ksu-eclub/magnetic-chess/mechanical/Pieces/king.PNG

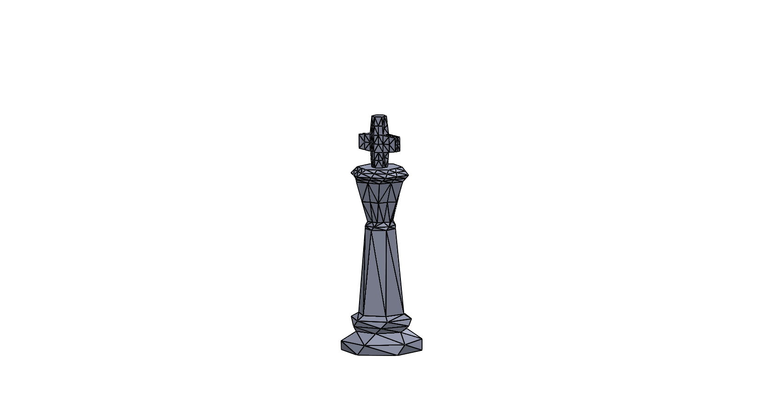
mechanical/Pieces/king.PNG
