ksu-eclub/magnetic-chess/mechanical/Board/LED Module Jig.SLDASM

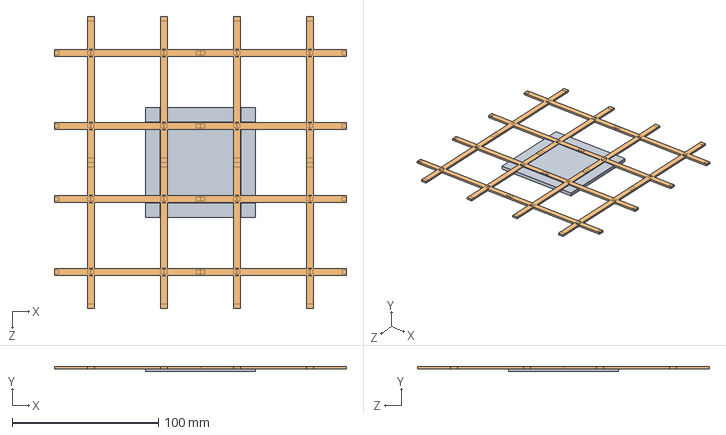
[picture p2: CAD file, 2020-03-06]
mechanical/Board/LED Module Jig.SLDASM
200.0 x 3.67 x 200.0 mm
LED Module Jig
LED Module x 4
