ksu-eclub/magnetic-chess/mechanical/Drag Chain/Drag Chain.SLDASM

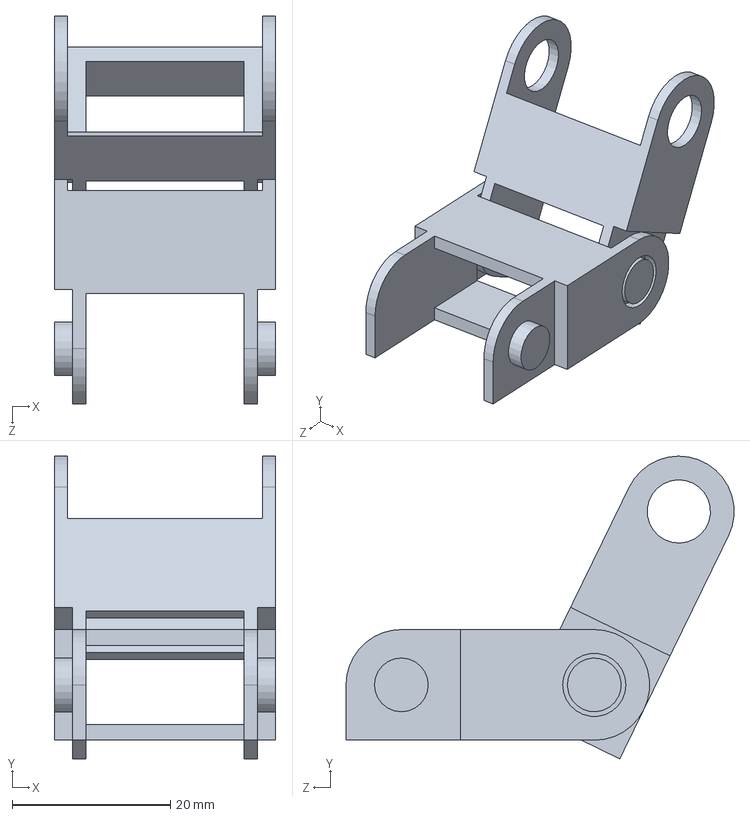
[picture p3: CAD file, 2020-02-17]
mechanical/Drag Chain/Drag Chain.SLDASM
28.0 x 38.3 x 49.1 mm
Drag Chain Link x 2
