ksu-eclub/magnetic-chess/mechanical/Magnetic Chess.SLDASM

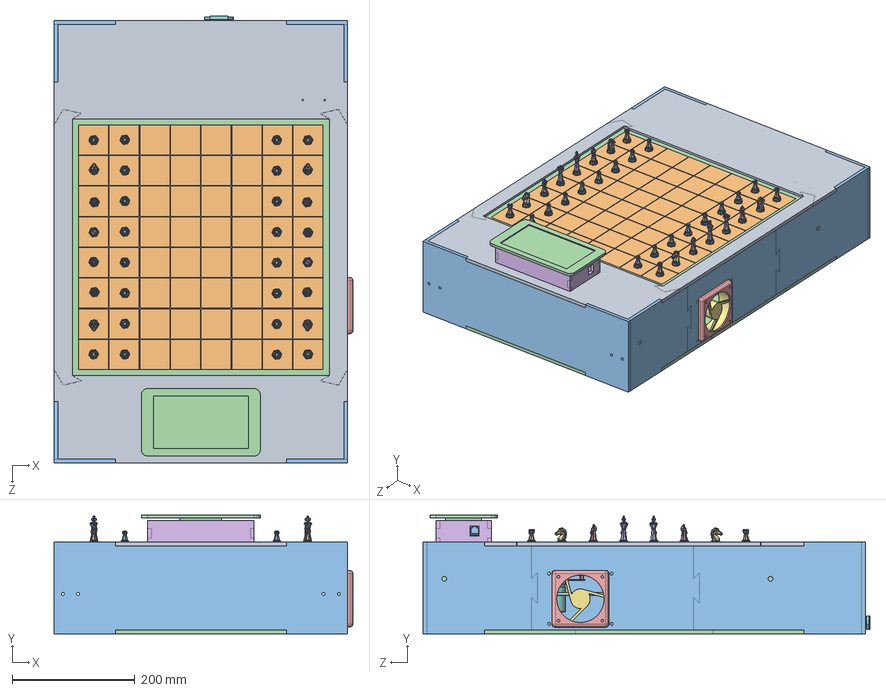
[picture p4: CAD file, 2020-02-26]
mechanical/Magnetic Chess.SLDASM
487.6 x 193.9 x 728.2 mm
Top
Top Board Mount x 4
Side x 4
Bottom
Fan Mount
Screen Side x 4
PSU Side x 2
PSU Top
Trim x 49
Tile x 64
LED Module x 16
Clear Board Epoxy
Bishop x 4
king x 2
knight x 4
pawn x 16
queen x 2
rook x 4
Power Supply
Axle x 10
Bearing x 16
Bearing Flange x 4
Pulley x 12
Belt x 6
Stepper Motor x 2
Stepper Plate
Cross-Axis Support x 2
Clamp x 4
Standoff x 31
stepper x 2
Magnet Holder
magnet driver
Electromagnet
Pi Hat
Raspberry Pi 3
Touch Screen
LED Controller
Power Entry
Fan
Power Plug
