ksu-eclub/magnetic-chess/mechanical/Board/Board.SLDASM

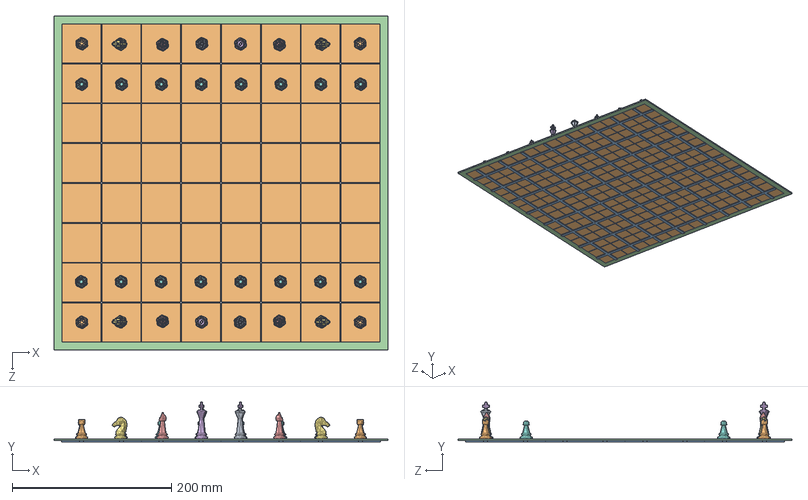
[picture p5: CAD file, 2020-02-17]
mechanical/Board/Board.SLDASM
419.0 x 50.1 x 419.0 mm
Trim x 49
Tile x 64
LED Module x 16
Clear Board Epoxy
Bishop x 4
king x 2
knight x 4
pawn x 16
queen x 2
rook x 4
