ksu-eclub/magnetic-chess/mechanical/Gantry/Secondary Axis.SLDASM

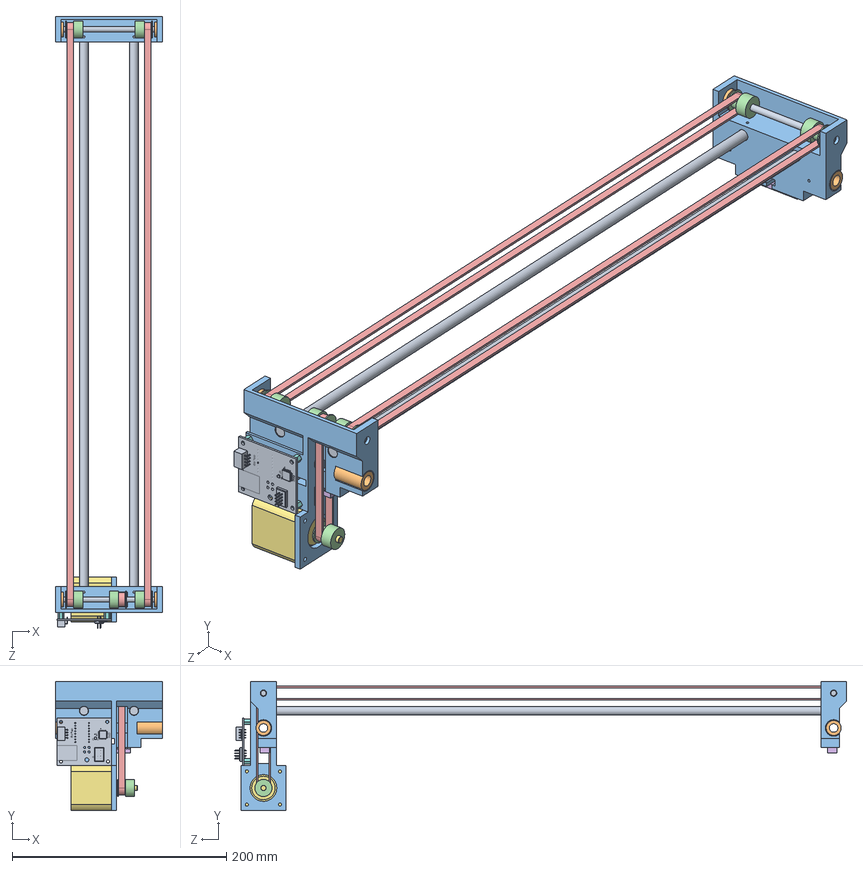
[picture p6: CAD file, 2020-02-26]
mechanical/Gantry/Secondary Axis.SLDASM
100.0 x 120.7 x 571.0 mm
Axle x 4
Bearing x 8
Cross-Axis Support x 2
Pulley x 6
Belt x 3
Clamp x 2
Stepper Motor
Standoff x 4
stepper
