ksu-eclub/magnetic-chess/mechanical/Box/Box.SLDASM

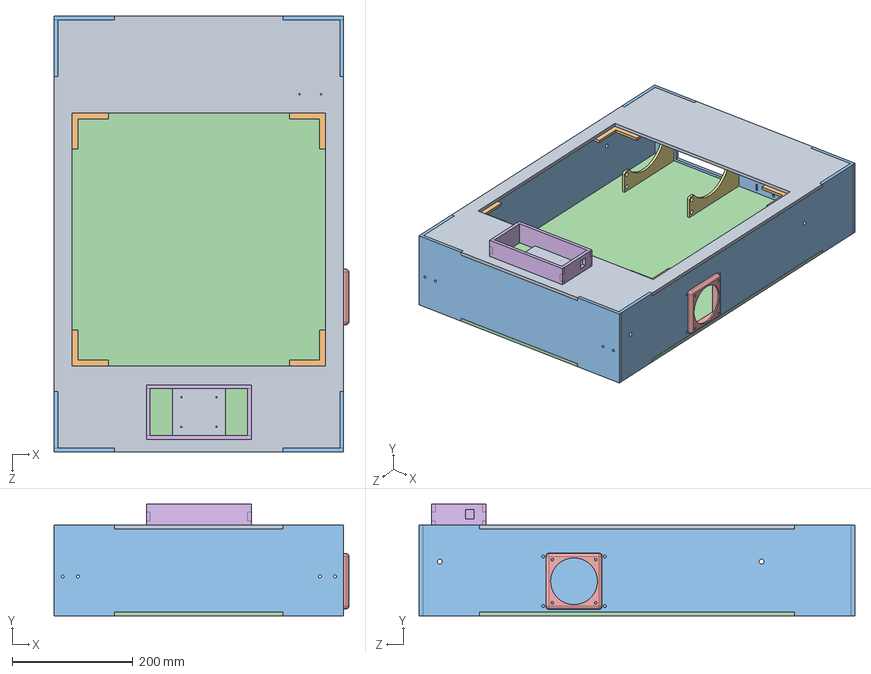
[picture p7: CAD file, 2020-02-20]
mechanical/Box/Box.SLDASM
487.6 x 185.0 x 721.0 mm
Top
Top Board Mount x 4
Side x 4
Bottom
Fan Mount
Screen Side x 4
PSU Side x 2
PSU Top
