ksu-eclub/magnetic-chess/mechanical/Gantry/Magnet Holder.SLDASM

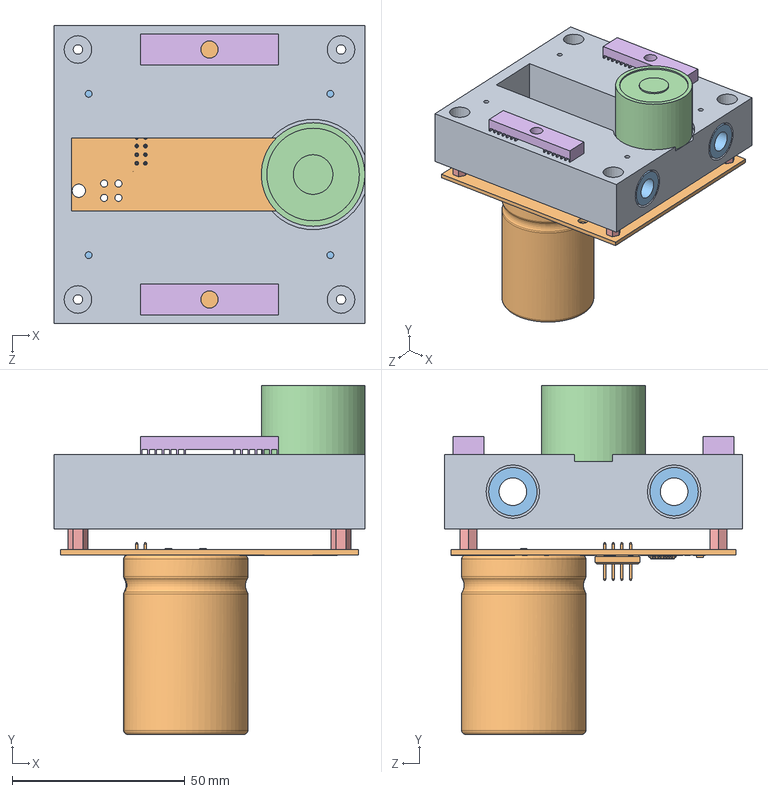
[picture p8: CAD file, 2020-02-26]
mechanical/Gantry/Magnet Holder.SLDASM
90.0 x 101.1 x 86.2 mm
Magnet Holder
magnet driver
Bearing x 4
Electromagnet
Standoff x 4
Clamp x 2
