ksu-eclub/magnetic-chess/mechanical/Laser-Cutting/0.25in MDF - Magnetic Chess.SLDASM

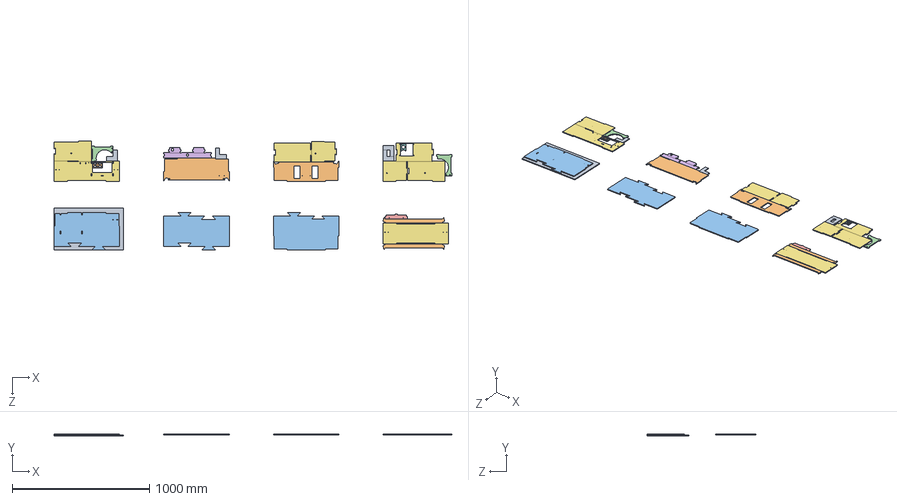
[picture p9: CAD file, 2020-02-21]
mechanical/Laser-Cutting/0.25in MDF - Magnetic Chess.SLDASM
2903.4 x 12.7 x 793.7 mm
Bearing Flange x 4
Bottom x 3
PSU Side x 2
PSU Top
Screen Side x 4
Side x 8
Stepper Plate
Top Board Mount x 4
Top x 4
