ksu-eclub/magnetic-chess/mechanical/Box/Lid.SLDASM

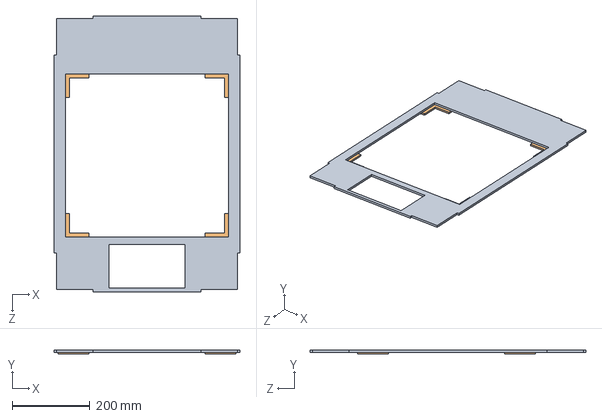
[picture p10: CAD file, 2020-02-20]
mechanical/Box/Lid.SLDASM
479.0 x 11.4 x 711.0 mm
Top
Top Board Mount x 4
