ksu-eclub/magnetic-chess/mechanical/Gantry/Base Pulley Rod.SLDASM

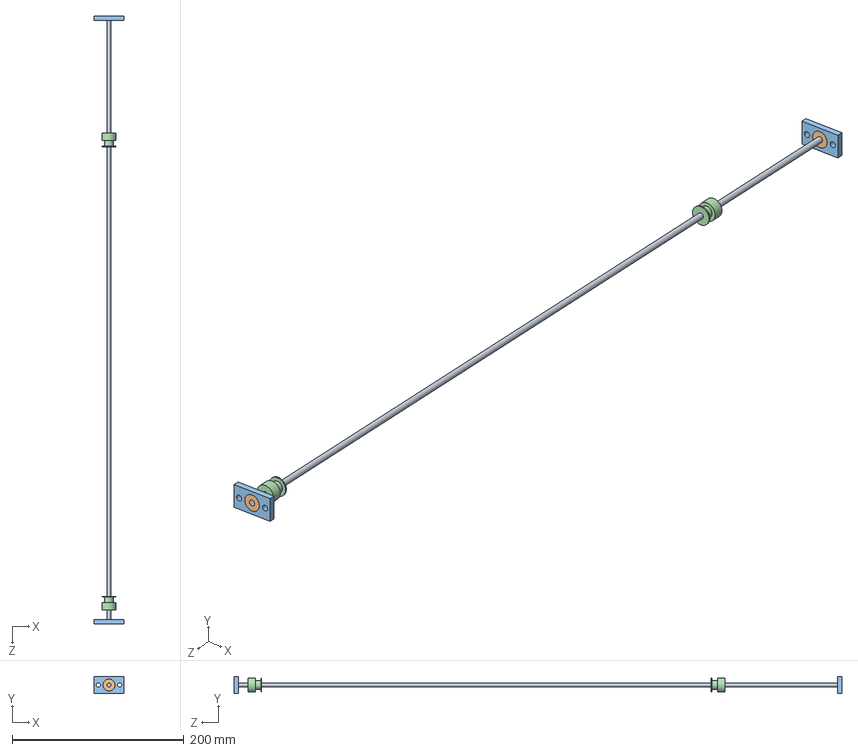
[picture p11: CAD file, 2020-02-20]
mechanical/Gantry/Base Pulley Rod.SLDASM
35.0 x 20.0 x 708.3 mm
Axle
Bearing x 2
Bearing Flange x 2
Pulley x 2
