ksu-eclub/magnetic-chess/mechanical/Gantry/Gantry Testing.SLDASM

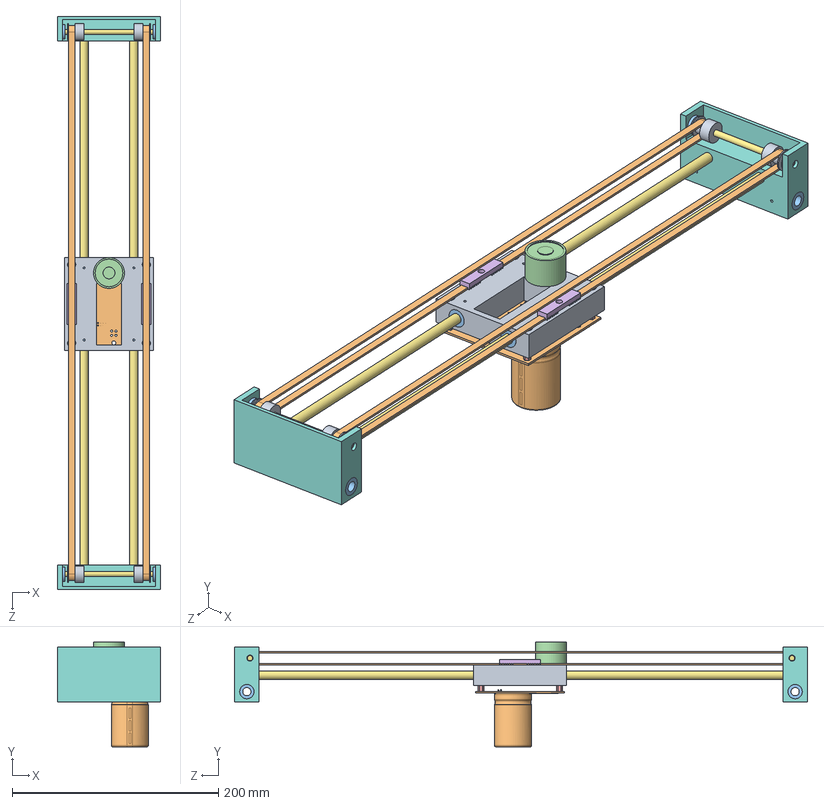
[picture p12: CAD file, 2020-02-19]
mechanical/Gantry/Gantry Testing.SLDASM
100.0 x 101.6 x 556.0 mm
Magnet Holder
magnet driver
Bearing x 12
Electromagnet
Standoff x 4
Clamp x 2
Axle x 4
Cross-Axis Support x 2
Pulley x 4
Belt x 2
