ksu-eclub/magnetic-chess/mechanical/Gantry/Gantry.SLDASM

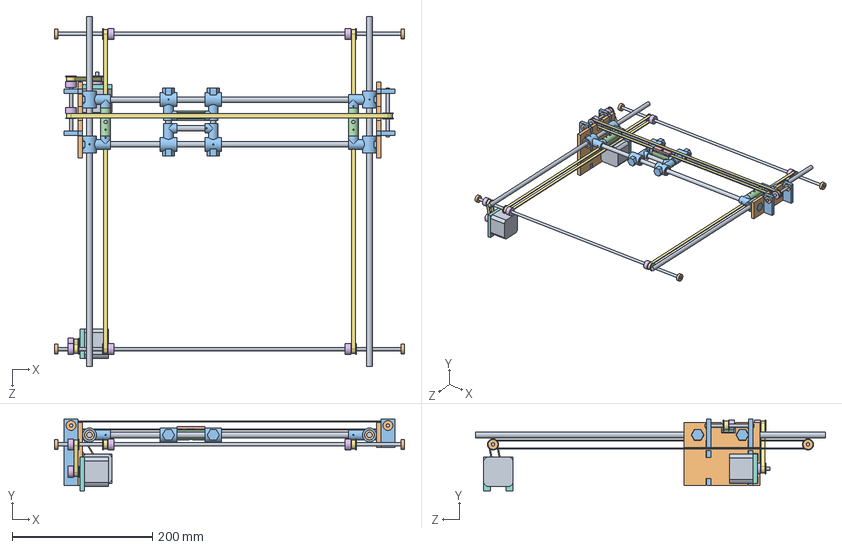
[picture p13: CAD file, 2020-02-19]
mechanical/Gantry/Gantry.SLDASM
500.0 x 102.8 x 500.0 mm
Axle x 14
Bearing x 16
Linear Bearing Holder x 8
Clamp Plate x 3
Clamp x 3
Pulley x 10
Belt x 5
Stepper Plate x 2
Stepper Motor x 2
Y Attachment Plate x 2
Y Rib x 4
