ksu-eclub/magnetic-chess/mechanical/3D Printing/LED Module Jig.STL

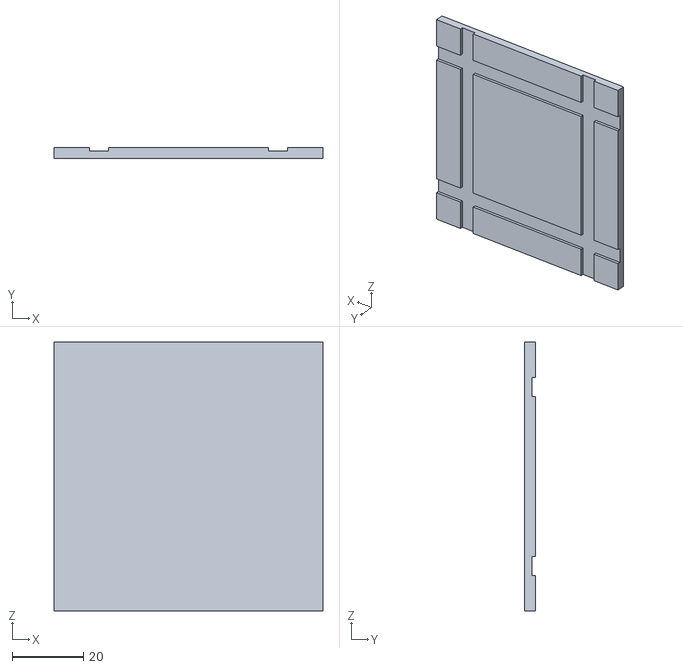
[picture p14: CAD file, 2020-03-06]
mechanical/3D Printing/LED Module Jig.STL
75.6 x 3.00 x 75.6
