ksu-eclub/magnetic-chess/mechanical/Box/Side.SLDPRT

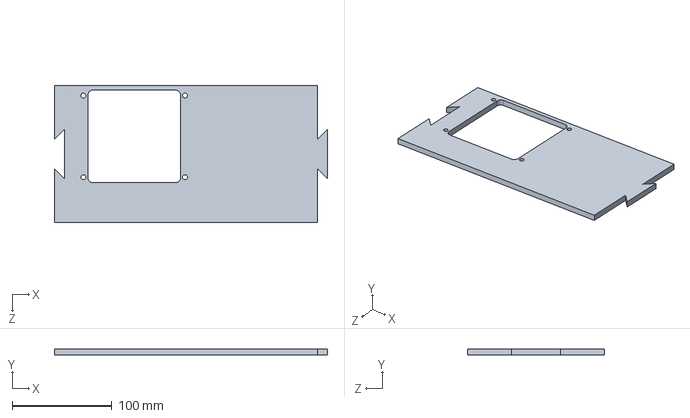
[picture p15: CAD file, 2020-02-20]
mechanical/Box/Side.SLDPRT
274.0 x 6.35 x 137.3 mm
