ksu-eclub/magnetic-chess/mechanical/Commercial Parts/Standoff.SLDPRT

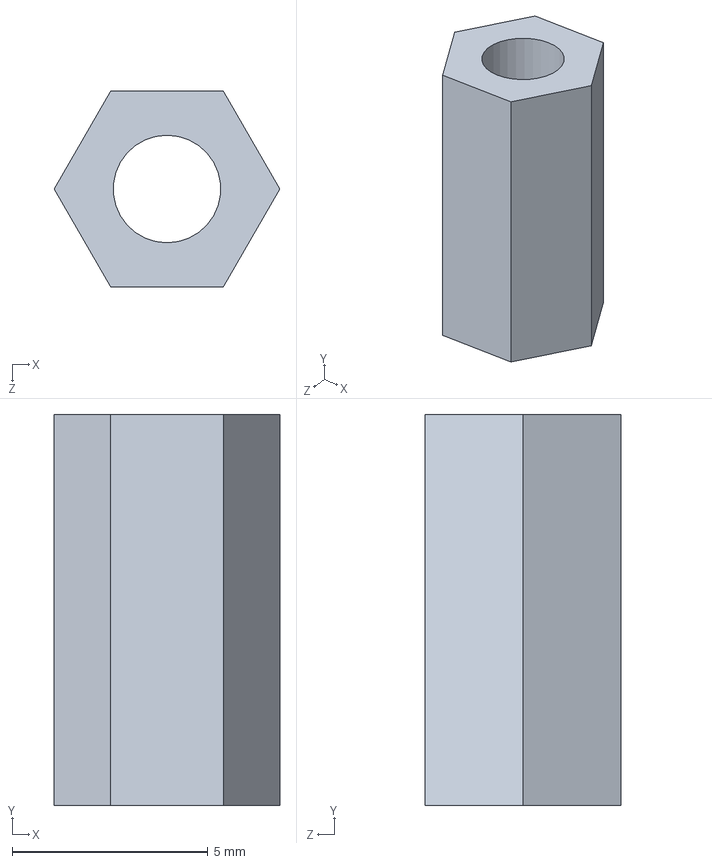
[picture p16: CAD file, 2020-02-19]
mechanical/Commercial Parts/Standoff.SLDPRT
5.77 x 10.0 x 5.00 mm
