ksu-eclub/magnetic-chess/mechanical/Gantry/Pulley Spacer.SLDPRT

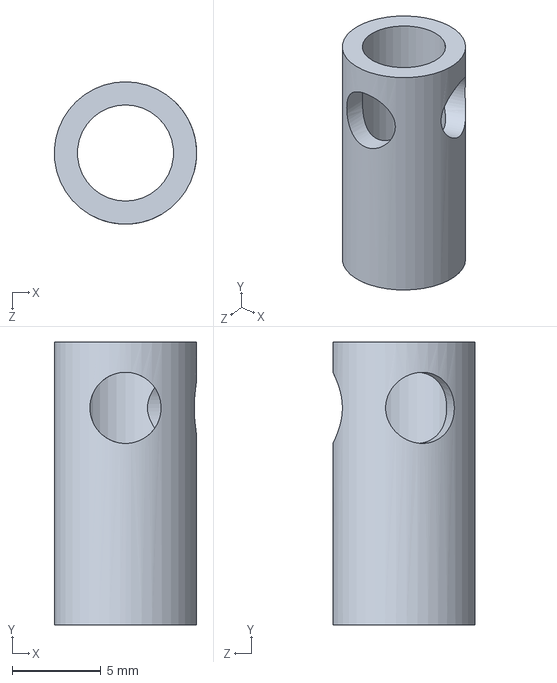
[picture p17: CAD file, 2020-02-28]
mechanical/Gantry/Pulley Spacer.SLDPRT
8.00 x 15.9 x 8.00 mm
