ksu-eclub/magnetic-chess/mechanical/PCBs/LED Controller.step

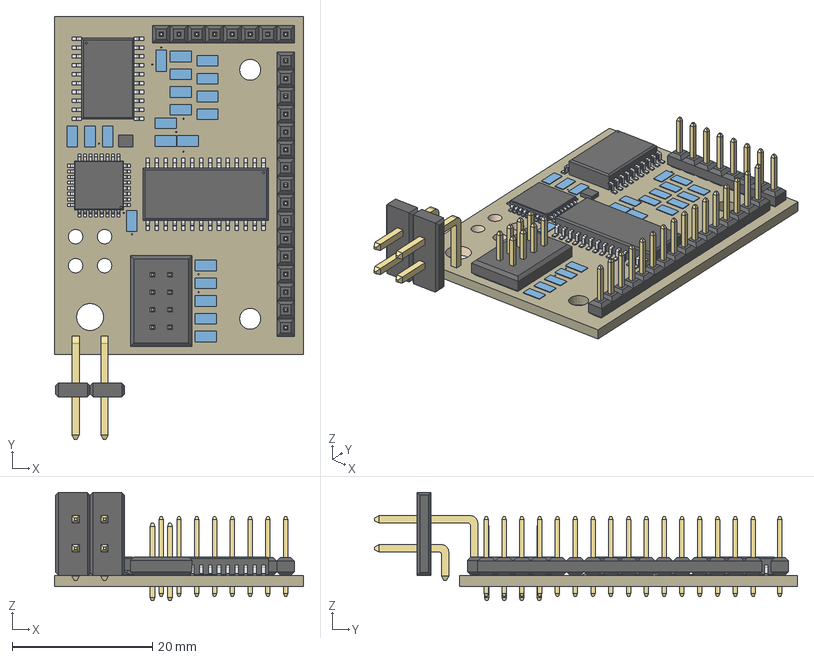
[picture p19: CAD file, 2020-02-17]
mechanical/PCBs/LED Controller.step
35.6 x 60.4 x 15.5 mm
Board
10k x 21
DF1BZ-8DP-2.5DSA
LED8
LED16
MCP23S08-E/SO
ATMEGA328PB32-TQFP
MCP23S17T-E/SO
8 MHz
