ksu-eclub/magnetic-chess/mechanical/Pieces/Bishop.SLDPRT

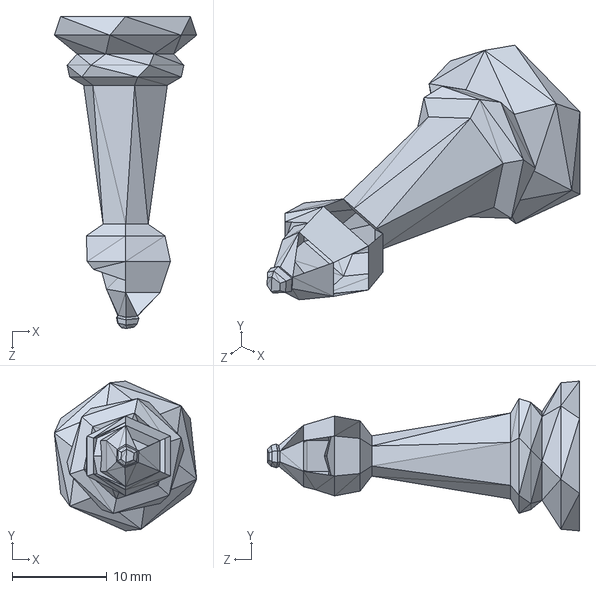
[picture p20: CAD file, 2020-02-17]
mechanical/Pieces/Bishop.SLDPRT
15.1 x 15.8 x 33.0 mm
