ksu-eclub/magnetic-chess/mechanical/Box/Top.SLDPRT

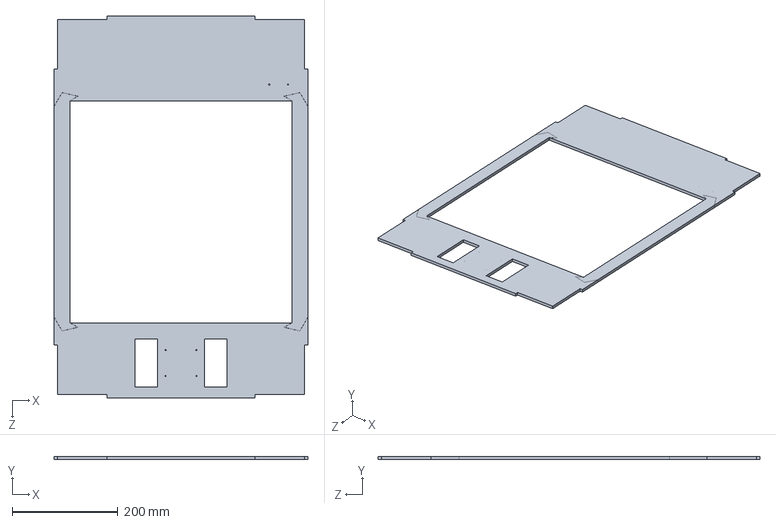
[picture p21: CAD file, 2020-02-20]
mechanical/Box/Top.SLDPRT
479.0 x 6.35 x 721.0 mm
