ksu-eclub/magnetic-chess/mechanical/Commercial Parts/Raspberry Pi 3.SLDPRT

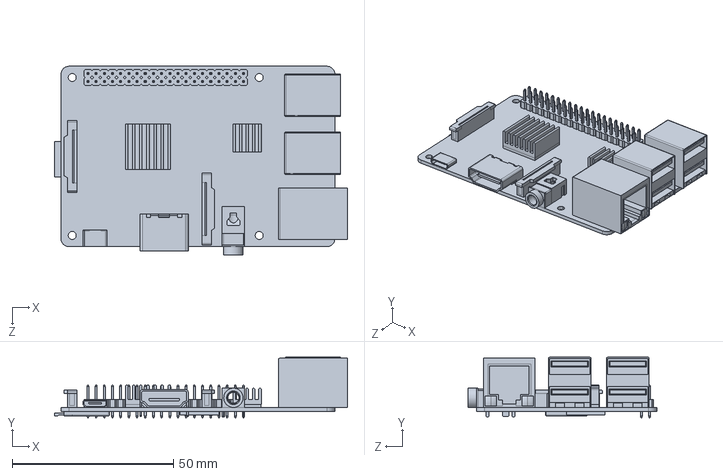
[picture p22: CAD file, 2020-02-19]
mechanical/Commercial Parts/Raspberry Pi 3.SLDPRT
90.9 x 18.8 x 58.5 mm
