ksu-eclub/magnetic-chess/mechanical/Drag Chain/Drag Chain Link.SLDPRT

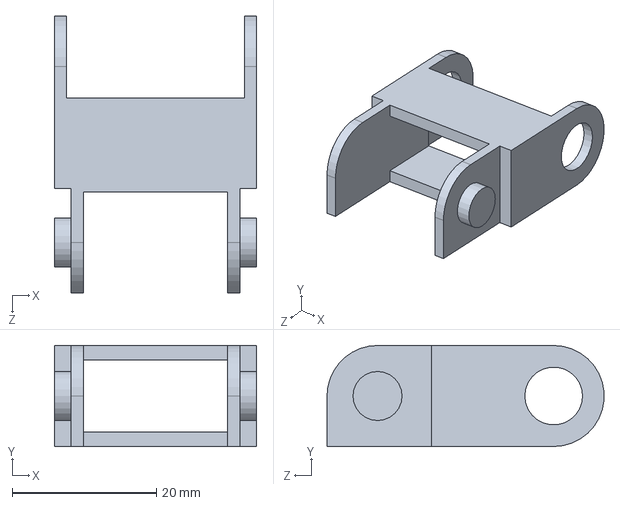
[picture p23: CAD file, 2020-02-17]
mechanical/Drag Chain/Drag Chain Link.SLDPRT
28.0 x 14.0 x 38.4 mm
