ksu-eclub/magnetic-chess/mechanical/Laser-Cutting/0.25in MDF - Magnetic Chess - 8.dxf

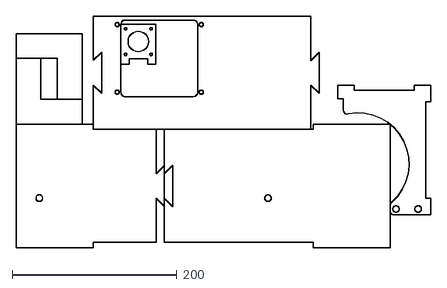
[picture p24: CAD file, 2020-02-21]
mechanical/Laser-Cutting/0.25in MDF - Magnetic Chess - 8.dxf
503.4 x 281.0
