ksu-eclub/magnetic-chess/mechanical/PCBs/Power Entry.step

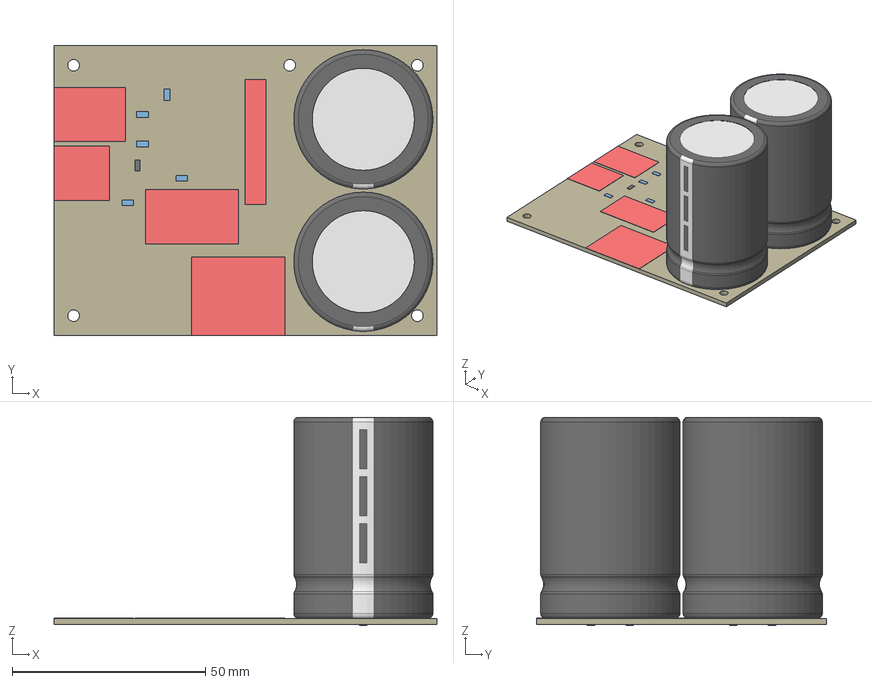
[picture p25: CAD file, 2020-02-17]
mechanical/PCBs/Power Entry.step
99.1 x 74.9 x 53.9 mm
Board
GBJ1004-BP
1000 uF x 2
2.7M x 5
BAT54HT1GBAT54HT1G
ALQ3F12
703W-00/04
