ksu-eclub/magnetic-chess/mechanical/Pieces/queen.SLDPRT

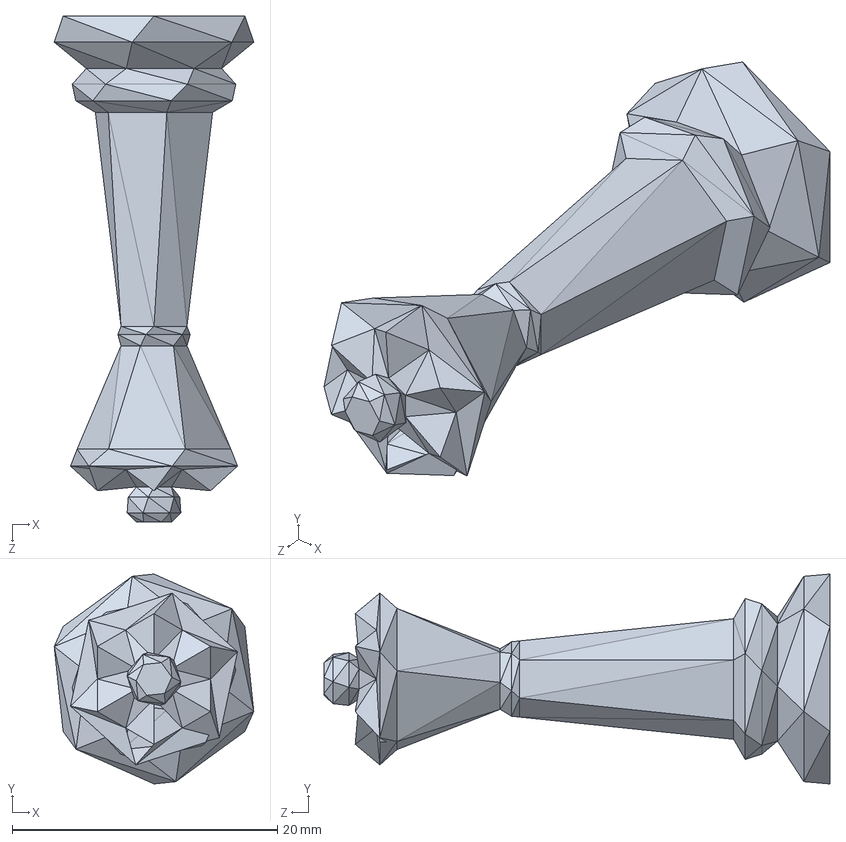
[picture p26: CAD file, 2020-02-17]
mechanical/Pieces/queen.SLDPRT
15.1 x 15.8 x 38.2 mm
