ksu-eclub/magnetic-chess/mechanical/3D Printing/Cross-Axis Support - Idler.STL

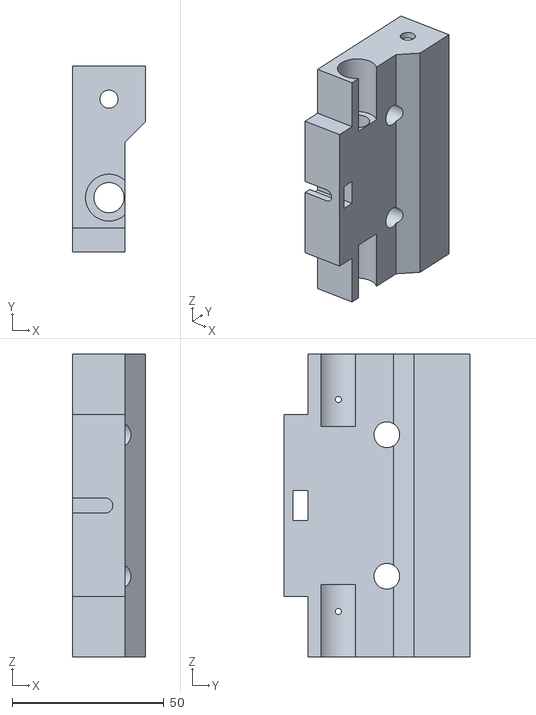
[picture p27: CAD file, 2020-02-26]
mechanical/3D Printing/Cross-Axis Support - Idler.STL
24.0 x 61.5 x 100.0
