ksu-eclub/magnetic-chess/mechanical/Board/Clear Board Epoxy.SLDPRT

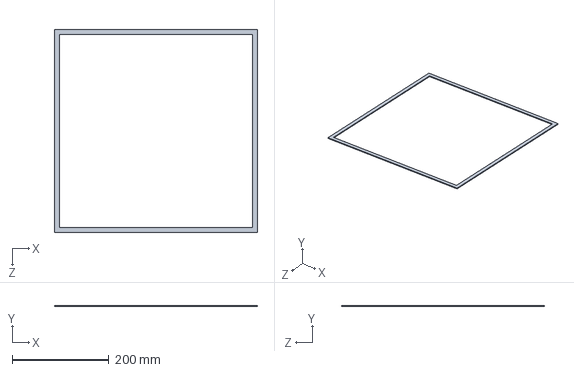
[picture p28: CAD file, 2020-02-17]
mechanical/Board/Clear Board Epoxy.SLDPRT
419.0 x 2.20 x 419.0 mm
