ksu-eclub/magnetic-chess/mechanical/Commercial Parts/Power Plug.SLDPRT

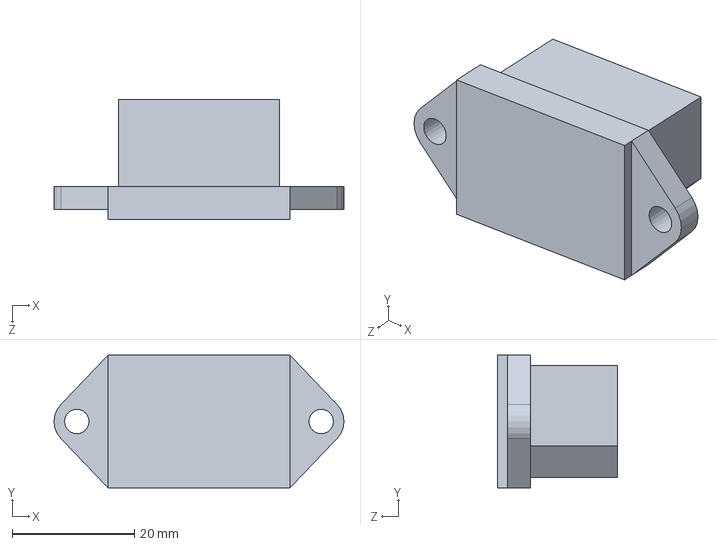
[picture p29: CAD file, 2020-02-17]
mechanical/Commercial Parts/Power Plug.SLDPRT
47.5 x 21.7 x 19.6 mm
