ksu-eclub/magnetic-chess/mechanical/PCBs/Pi Hat.step

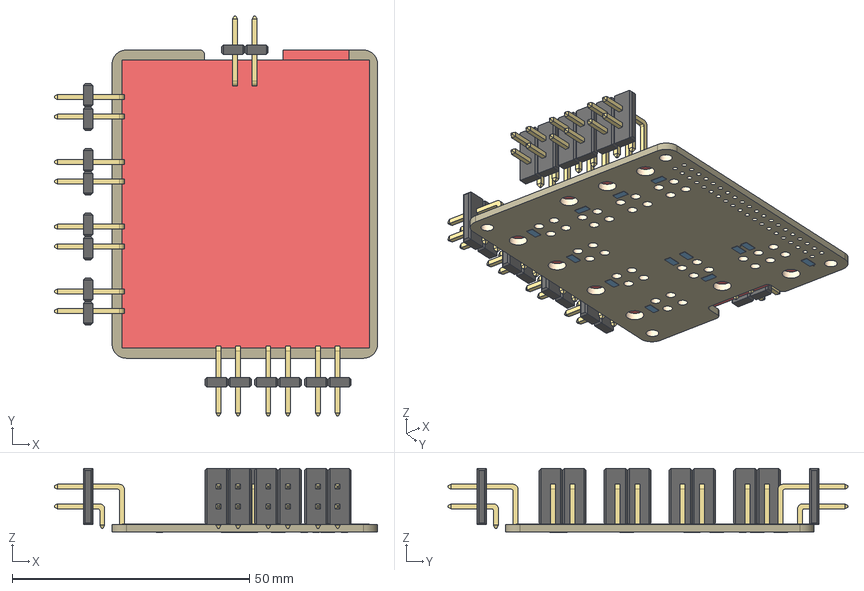
[picture p30: CAD file, 2020-02-17]
mechanical/PCBs/Pi Hat.step
68.2 x 84.3 x 13.5 mm
Board
4.7k x 13
RPI
