ksu-eclub/magnetic-chess/mechanical/Pieces/knight.SLDPRT

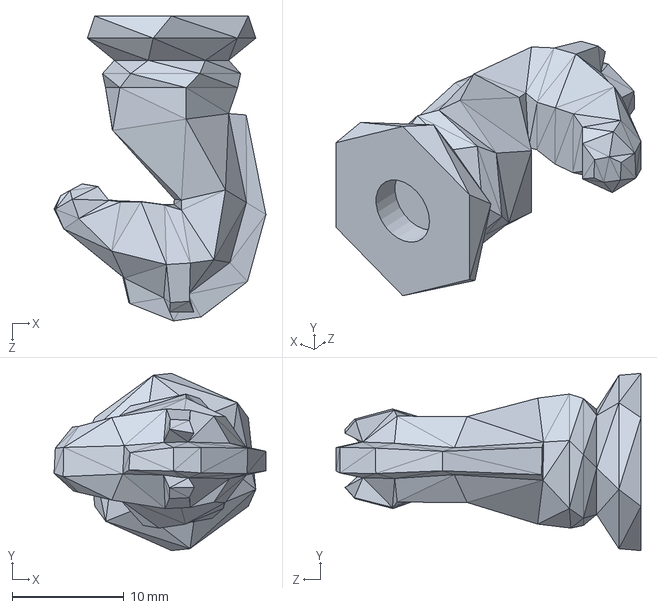
[picture p31: CAD file, 2020-02-17]
mechanical/Pieces/knight.SLDPRT
18.9 x 15.8 x 27.3 mm
