ksu-eclub/magnetic-chess/mechanical/3D Printing/Cross-Axis Support - Driver.STL

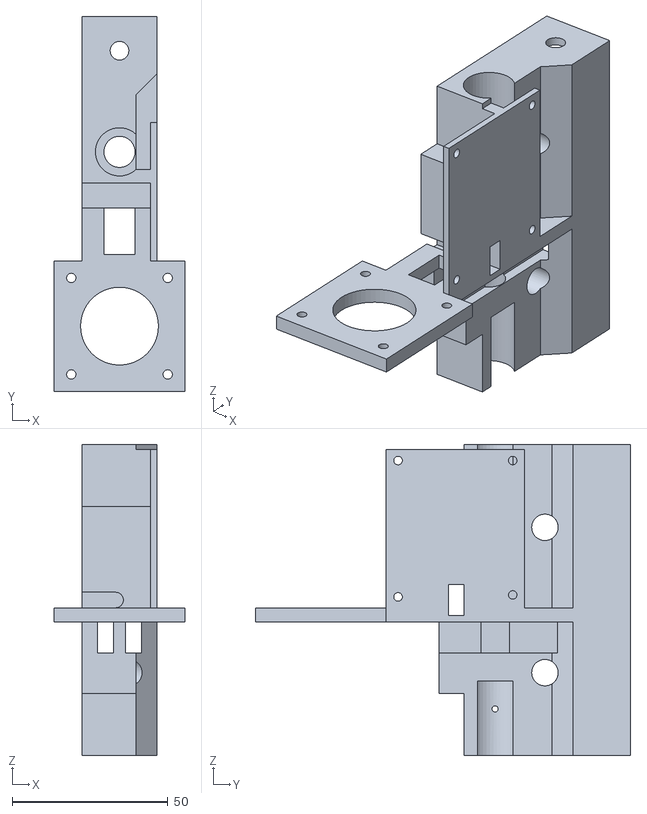
[picture p32: CAD file, 2020-02-26]
mechanical/3D Printing/Cross-Axis Support - Driver.STL
42.0 x 120.5 x 100.0
