ksu-eclub/magnetic-chess/mechanical/Board/Tile.SLDPRT

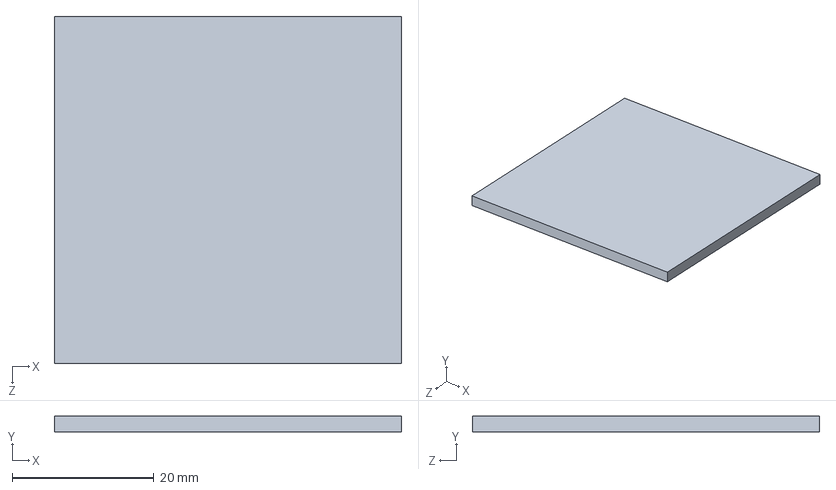
[picture p33: CAD file, 2020-02-17]
mechanical/Board/Tile.SLDPRT
49.0 x 2.20 x 49.0 mm
