ksu-eclub/magnetic-chess/mechanical/Box/Bottom.SLDPRT

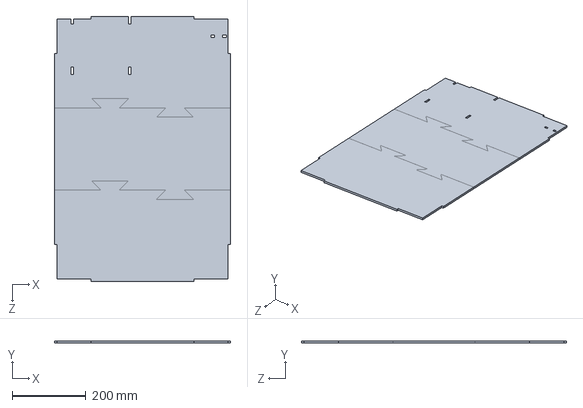
[picture p34: CAD file, 2020-02-20]
mechanical/Box/Bottom.SLDPRT
479.0 x 6.35 x 721.0 mm
