ksu-eclub/magnetic-chess/mechanical/Commercial Parts/Fan.SLDPRT

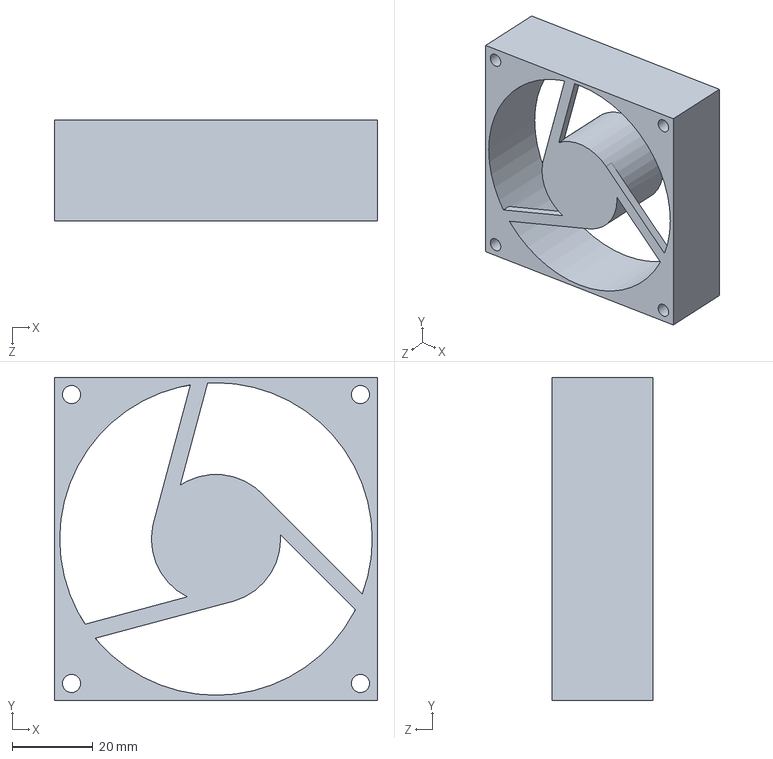
[picture p35: CAD file, 2020-02-17]
mechanical/Commercial Parts/Fan.SLDPRT
80.0 x 80.0 x 25.1 mm
