ksu-eclub/magnetic-chess/mechanical/Laser-Cutting/0.25in MDF - Magnetic Chess - 3.dxf

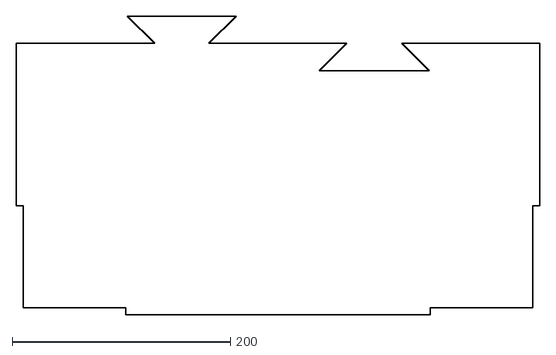
[picture p36: CAD file, 2020-02-21]
mechanical/Laser-Cutting/0.25in MDF - Magnetic Chess - 3.dxf
479.0 x 273.6
