ksu-eclub/magnetic-chess/mechanical/PCBs/stepper.step

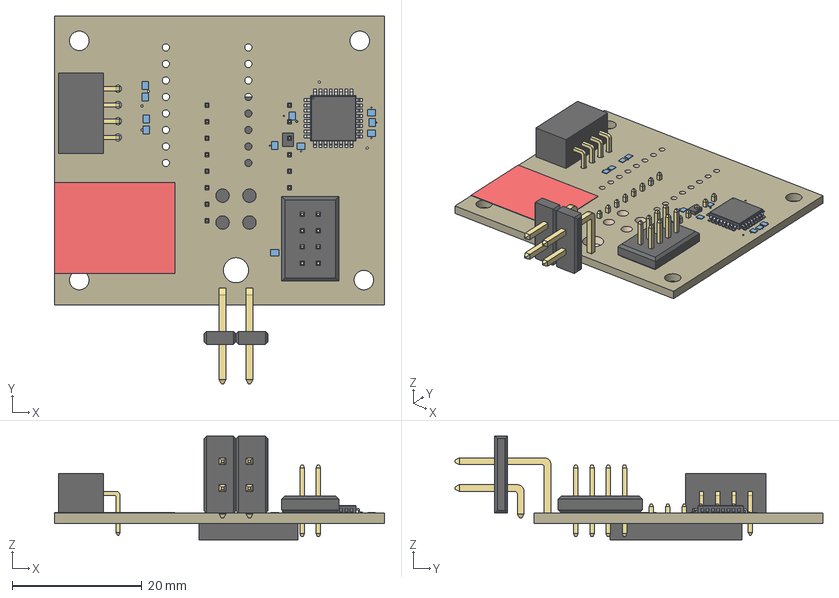
[picture p37: CAD file, 2020-02-17]
mechanical/PCBs/stepper.step
50.8 x 56.6 x 16.0 mm
Board
STEPPER_DRIVER
10k x 11
DF1BZ-8DP-2.5DSA
S4B-XH-A
ATMEGA328PB32-TQFP
16Meg
