ksu-eclub/magnetic-chess/mechanical/Pieces/rook.SLDPRT

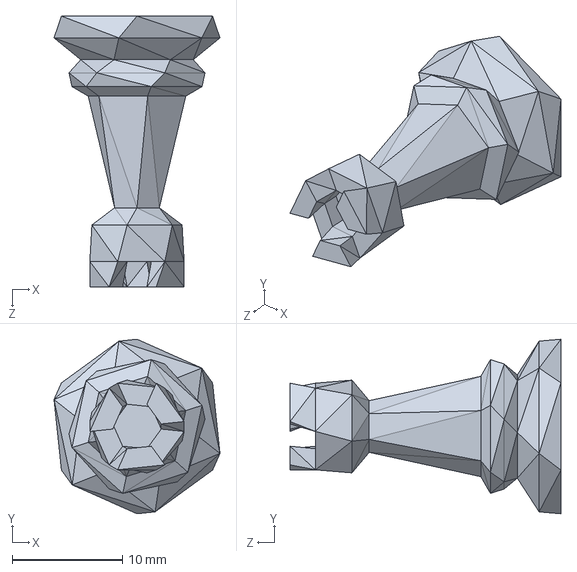
[picture p38: CAD file, 2020-02-17]
mechanical/Pieces/rook.SLDPRT
15.1 x 15.8 x 24.6 mm
