ksu-eclub/magnetic-chess/mechanical/3D Printing/Magnet Holder.STL

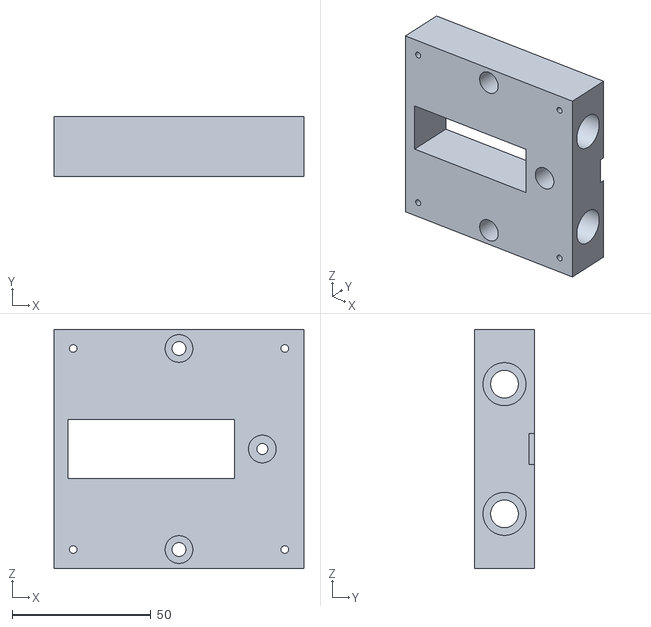
[picture p39: CAD file, 2020-02-26]
mechanical/3D Printing/Magnet Holder.STL
90.0 x 21.5 x 86.2
