ksu-eclub/magnetic-chess/mechanical/Board/Trim.SLDPRT

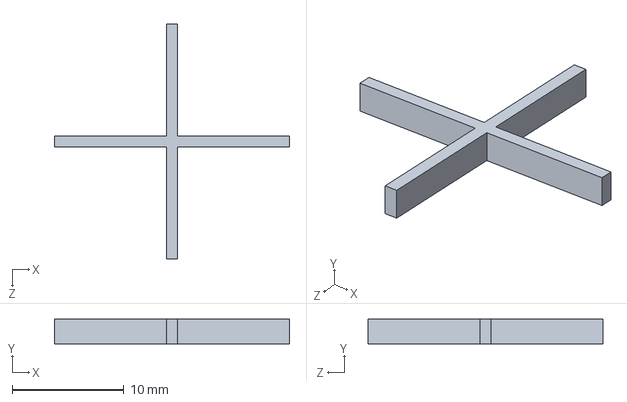
[picture p40: CAD file, 2020-02-17]
mechanical/Board/Trim.SLDPRT
21.0 x 2.20 x 21.0 mm
