ksu-eclub/magnetic-chess/mechanical/Commercial Parts/Electromagnet.SLDPRT

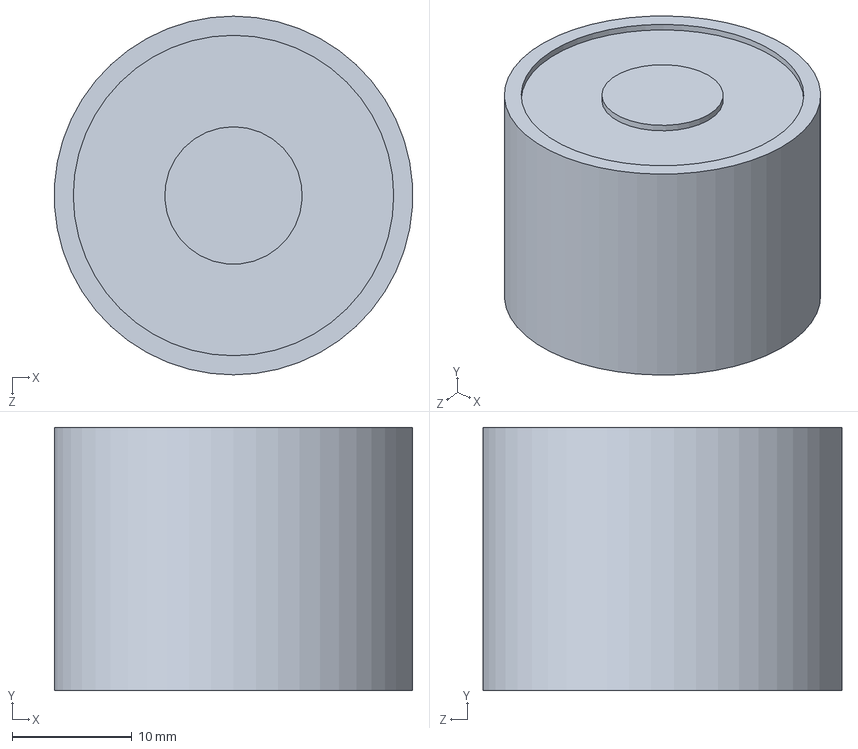
[picture p41: CAD file, 2020-02-17]
mechanical/Commercial Parts/Electromagnet.SLDPRT
29.9 x 22.0 x 30.0 mm
