ksu-eclub/magnetic-chess/mechanical/Laser-Cutting/0.25in MDF - Magnetic Chess - 2.dxf

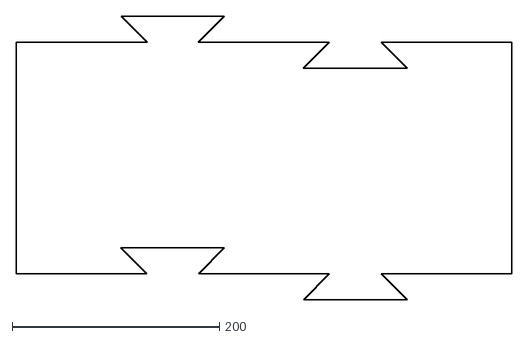
[picture p42: CAD file, 2020-02-21]
mechanical/Laser-Cutting/0.25in MDF - Magnetic Chess - 2.dxf
479.0 x 273.5
