ksu-eclub/magnetic-chess/mechanical/PCBs/LED Module.step

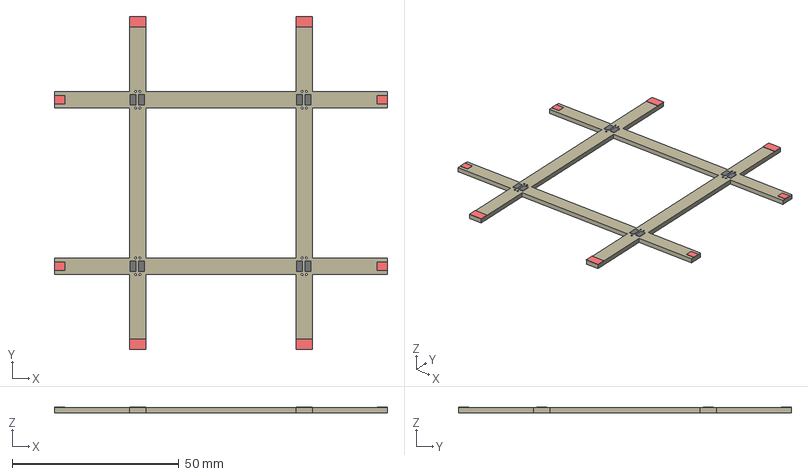
[picture p43: CAD file, 2020-02-17]
mechanical/PCBs/LED Module.step
100.0 x 100.0 x 1.67 mm
Board
LED x 8
LED_JUMPER_1 x 4
LED_JUMPER_2 x 4
