ksu-eclub/magnetic-chess/mechanical/Pieces/pawn.SLDPRT

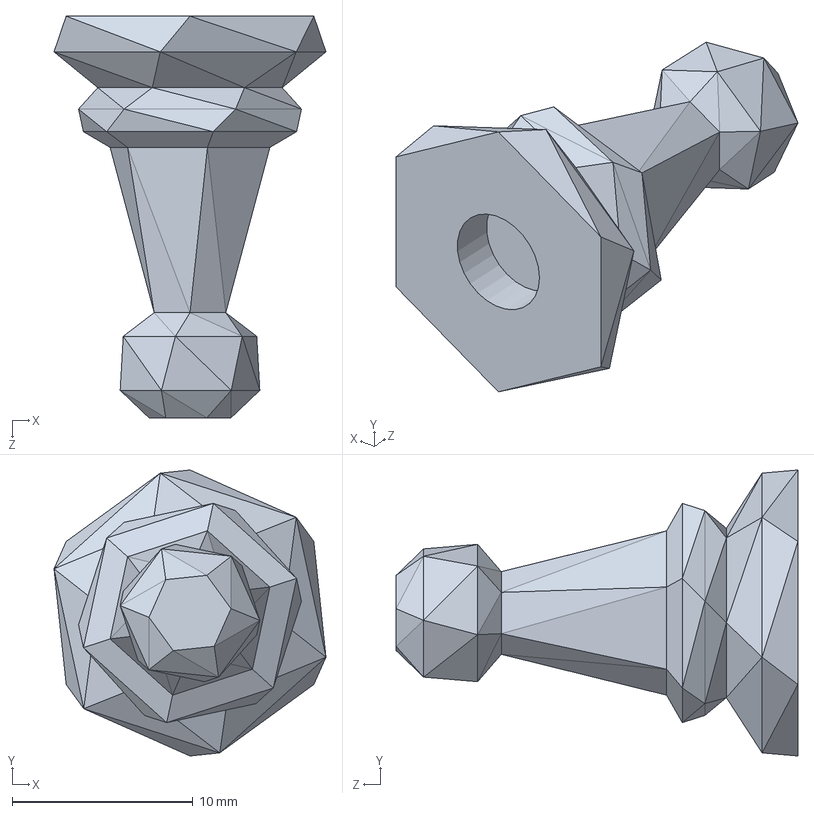
[picture p44: CAD file, 2020-02-17]
mechanical/Pieces/pawn.SLDPRT
15.1 x 15.8 x 22.2 mm
