ksu-eclub/magnetic-chess/mechanical/3D Printing/Fan Mount.STL

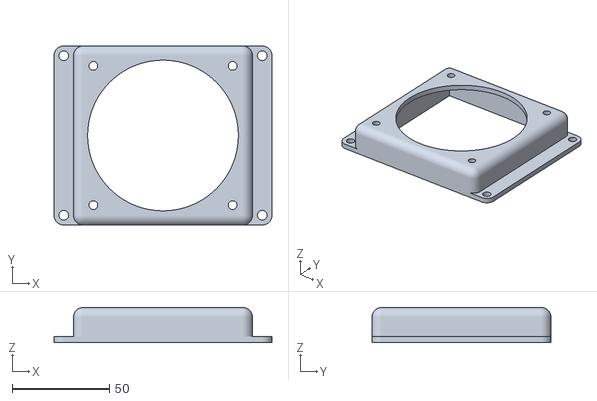
[picture p45: CAD file, 2020-02-23]
mechanical/3D Printing/Fan Mount.STL
112.0 x 92.0 x 18.0
