ksu-eclub/magnetic-chess/mechanical/Box/PSU Side.SLDPRT

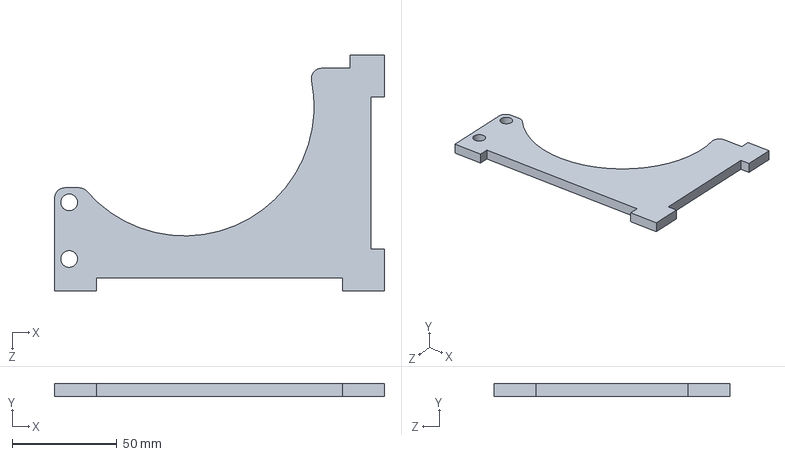
[picture p46: CAD file, 2020-02-20]
mechanical/Box/PSU Side.SLDPRT
157.4 x 6.35 x 112.7 mm
