ksu-eclub/magnetic-chess/mechanical/Commercial Parts/Touch Screen.SLDPRT

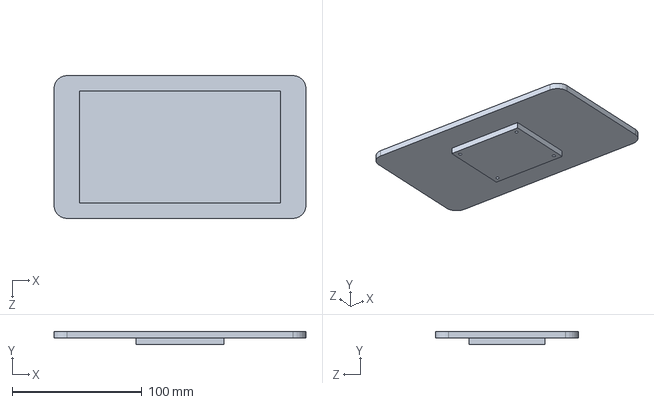
[picture p47: CAD file, 2020-02-17]
mechanical/Commercial Parts/Touch Screen.SLDPRT
194.0 x 10.0 x 110.0 mm
