ksu-eclub/magnetic-chess/mechanical/Gantry/Bearing Flange.SLDPRT

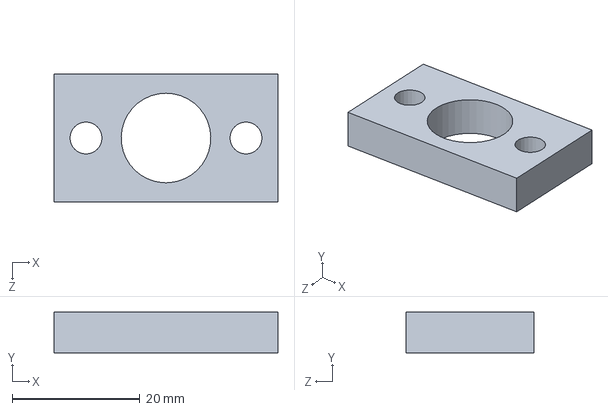
[picture p48: CAD file, 2020-02-20]
mechanical/Gantry/Bearing Flange.SLDPRT
35.0 x 6.35 x 20.0 mm
