ksu-eclub/magnetic-chess/mechanical/PCBs/magnet driver.step

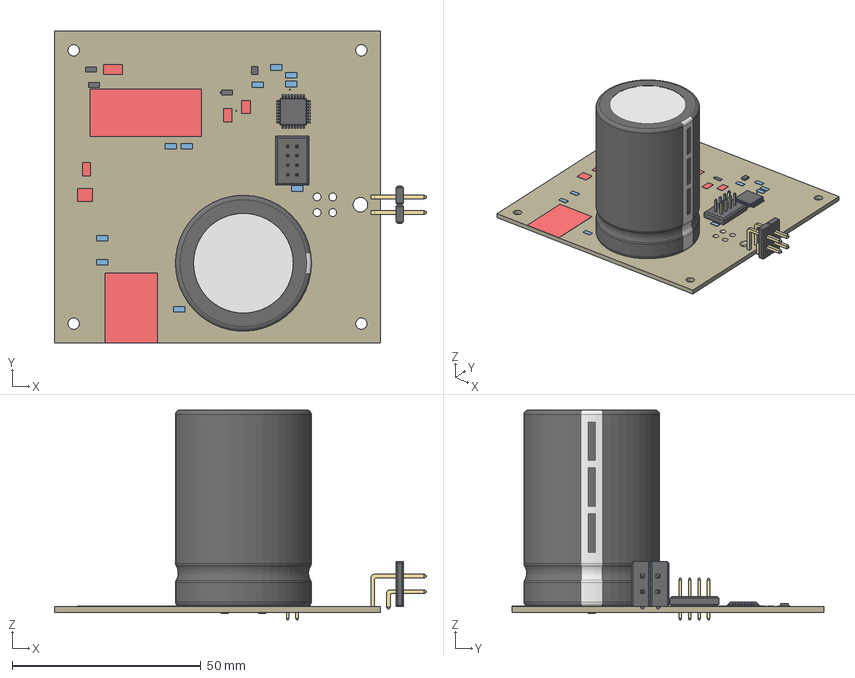
[picture p50: CAD file, 2020-02-17]
mechanical/PCBs/magnet driver.step
98.5 x 82.5 x 55.6 mm
Board
10k x 10
ESMQ351VSN102MA50S
BAT54HT1GBAT54HT1G x 3
DF1BZ-8DP-2.5DSA
G2RL-2DC12
ELECTROMAGNET
RK7002BMT116
DMN1019UVT-7DMN1019UVT-7
PMBT2222A,215PMBT2222A,215
ATMEGA328PB32-TQFP
MCP4011-103E/MSMCP4011-103E/MS
8 MHz
