ksu-eclub/magnetic-chess/mechanical/Pieces/king.STL

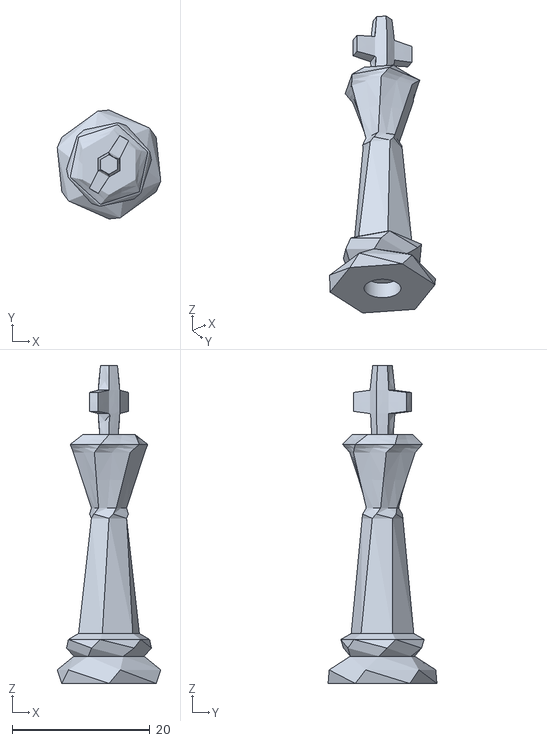
[picture p51: CAD file, 2020-02-17]
mechanical/Pieces/king.STL
15.1 x 15.8 x 46.2
