ksu-eclub/magnetic-chess/mechanical/Box/Top Board Mount.SLDPRT

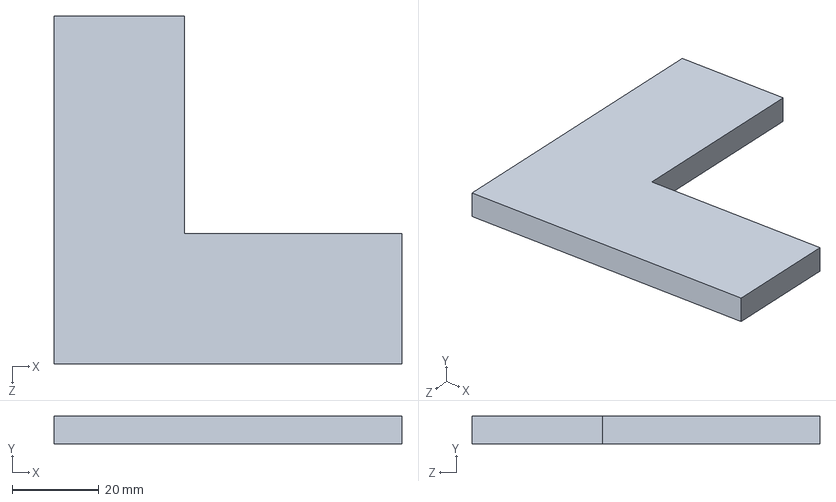
[picture p52: CAD file, 2020-02-20]
mechanical/Box/Top Board Mount.SLDPRT
80.0 x 6.35 x 80.0 mm
