ksu-eclub/magnetic-chess/mechanical/Commercial Parts/Power Supply.SLDPRT

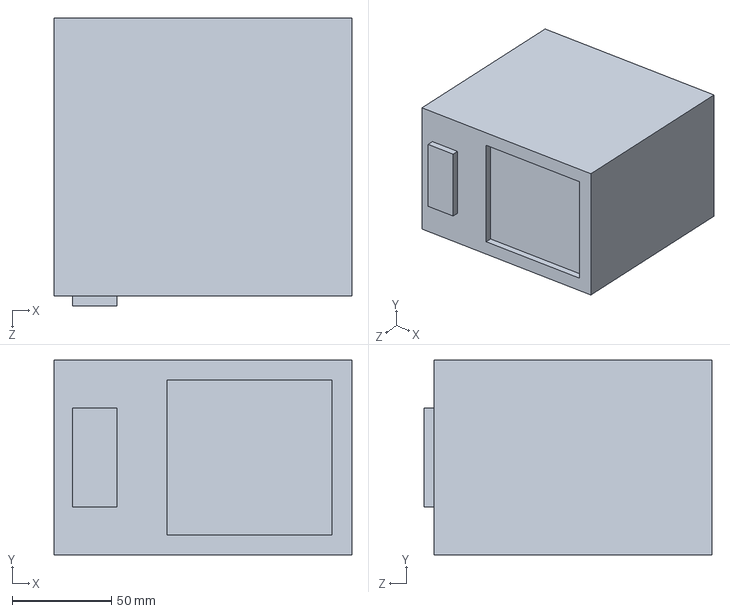
[picture p53: CAD file, 2020-02-17]
mechanical/Commercial Parts/Power Supply.SLDPRT
150.0 x 98.0 x 145.0 mm
