ksu-eclub/magnetic-chess/mechanical/Gantry/Stepper Plate.SLDPRT

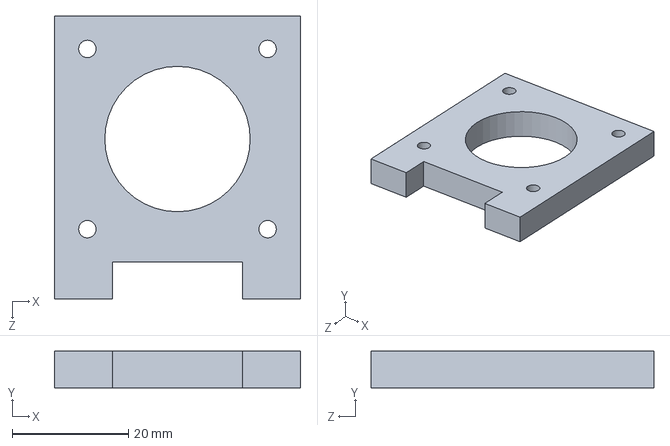
[picture p54: CAD file, 2020-02-20]
mechanical/Gantry/Stepper Plate.SLDPRT
42.3 x 6.35 x 48.7 mm
