ksu-eclub/magnetic-chess/mechanical/Box/PSU Top.SLDPRT

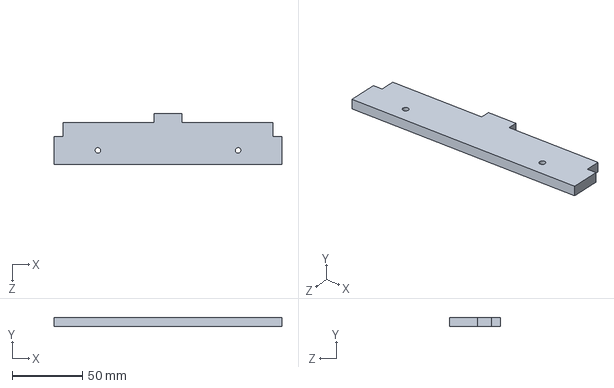
[picture p56: CAD file, 2020-02-20]
mechanical/Box/PSU Top.SLDPRT
162.7 x 6.35 x 36.4 mm
