ksu-eclub/magnetic-chess/mechanical/Gantry/Axle.SLDPRT

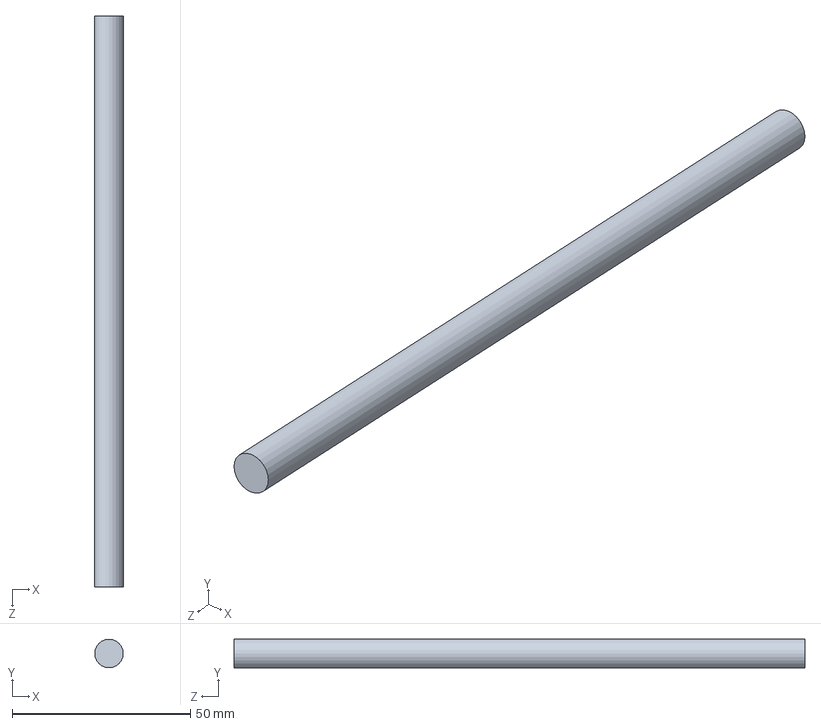
[picture p57: CAD file, 2020-02-19]
mechanical/Gantry/Axle.SLDPRT
8.00 x 8.00 x 160.0 mm
