ksu-eclub/magnetic-chess/mechanical/Box/Screen Side.SLDPRT

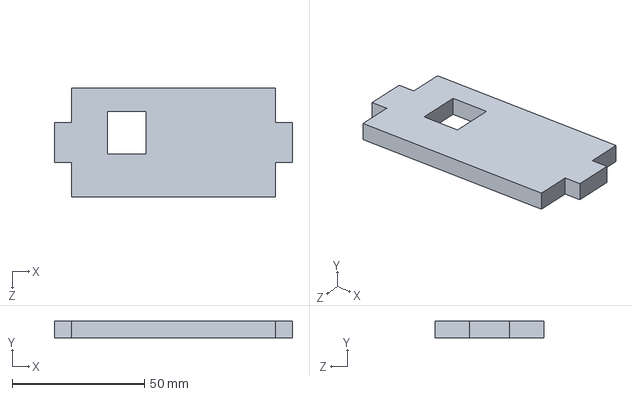
[picture p59: CAD file, 2020-02-19]
mechanical/Box/Screen Side.SLDPRT
90.0 x 6.35 x 41.3 mm
