ksu-eclub/magnetic-chess/mechanical/Gantry/Stepper Motor.SLDPRT

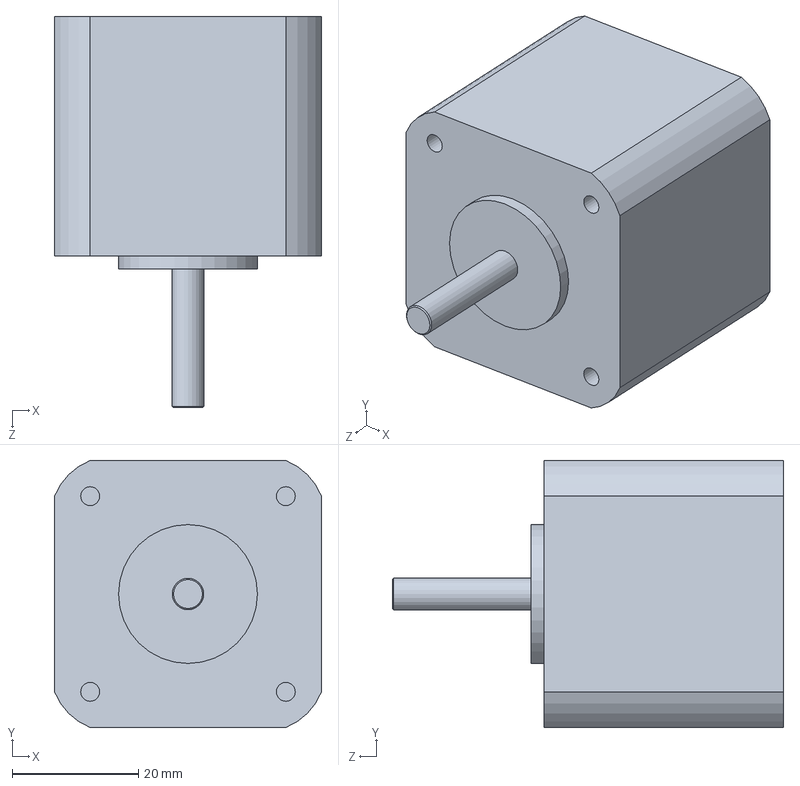
[picture p60: CAD file, 2020-02-19]
mechanical/Gantry/Stepper Motor.SLDPRT
42.3 x 42.3 x 62.0 mm
