ksu-eclub/magnetic-chess/mechanical/Gantry/Belt.SLDPRT

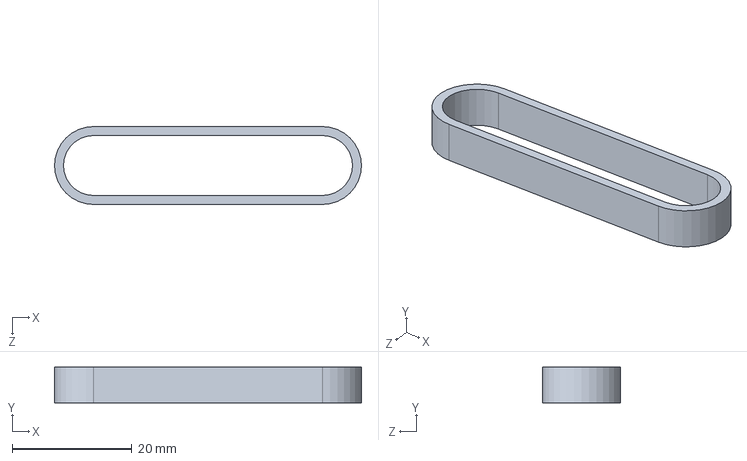
[picture p62: CAD file, 2020-02-19]
mechanical/Gantry/Belt.SLDPRT
51.3 x 6.00 x 13.0 mm
