ksu-eclub/magnetic-chess/mechanical/Laser-Cutting/2.2mm Acrylic - Magnetic Chess - 9.dxf

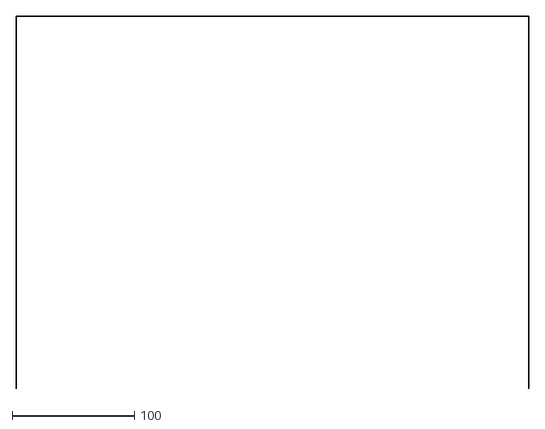
[picture p63: CAD file, 2020-02-21]
mechanical/Laser-Cutting/2.2mm Acrylic - Magnetic Chess - 9.dxf
419.0 x 304.9
