ksu-eclub/magnetic-chess/mechanical/Laser-Cutting/2.2mm Acrylic - Magnetic Chess - 10.dxf

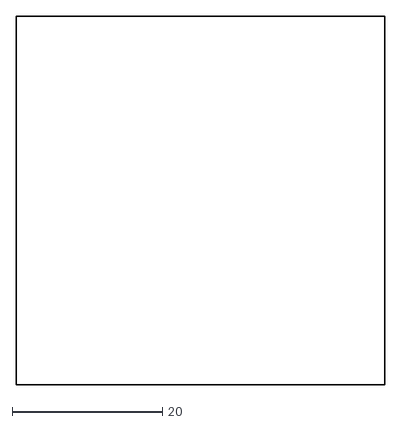
[picture p64: CAD file, 2020-02-21]
mechanical/Laser-Cutting/2.2mm Acrylic - Magnetic Chess - 10.dxf
49.0 x 49.0
