ksu-eclub/magnetic-chess/mechanical/Gantry/Bearing.SLDPRT

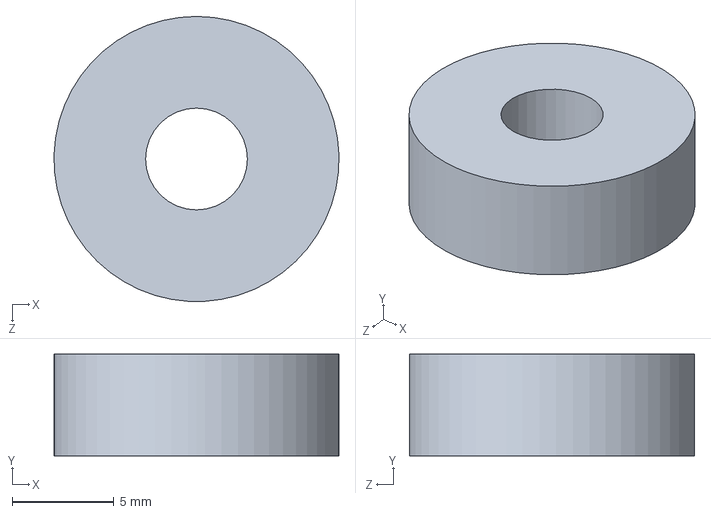
[picture p65: CAD file, 2020-02-19]
mechanical/Gantry/Bearing.SLDPRT
14.0 x 5.00 x 14.0 mm
