ksu-eclub/magnetic-chess/mechanical/Laser-Cutting/Laser Sheet.SLDPRT

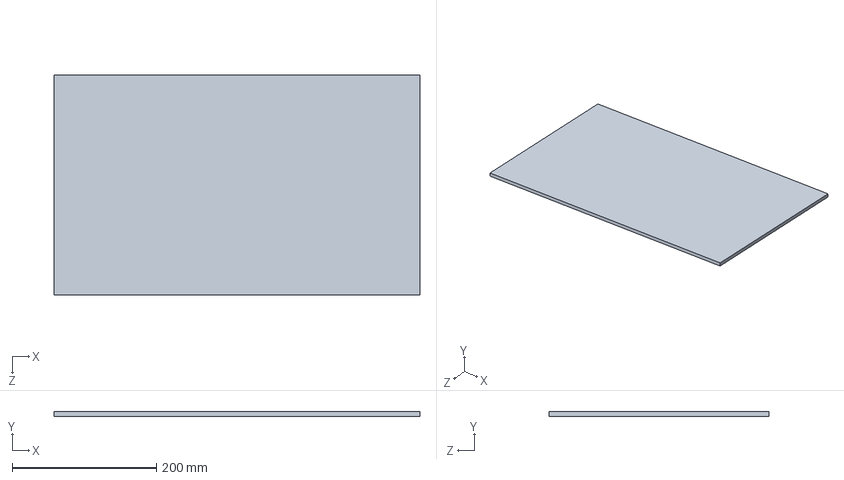
[picture p66: CAD file, 2020-02-20]
mechanical/Laser-Cutting/Laser Sheet.SLDPRT
508.0 x 6.35 x 304.8 mm
