ksu-eclub/magnetic-chess/mechanical/Gantry/Y Rib.SLDPRT

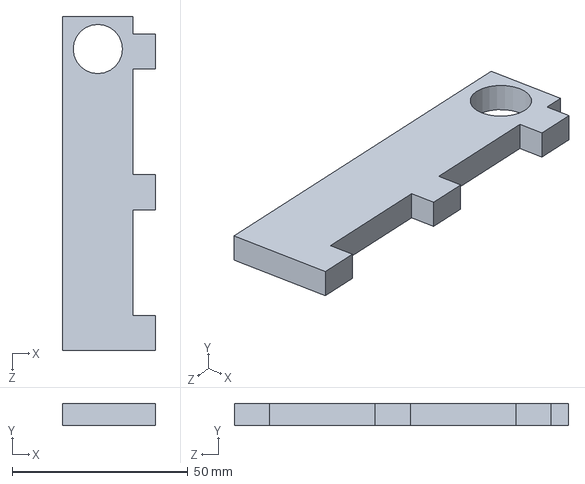
[picture p67: CAD file, 2020-02-17]
mechanical/Gantry/Y Rib.SLDPRT
26.4 x 6.35 x 95.0 mm
