ksu-eclub/magnetic-chess/mechanical/Gantry/Y Attachment Plate.SLDPRT

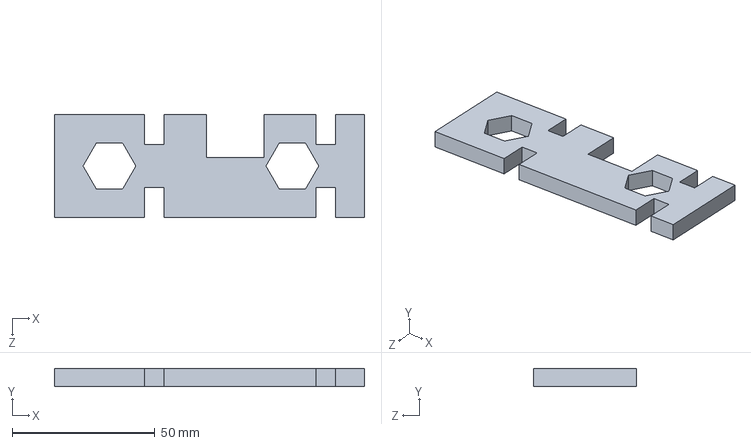
[picture p68: CAD file, 2020-02-17]
mechanical/Gantry/Y Attachment Plate.SLDPRT
108.5 x 6.35 x 36.0 mm
