ksu-eclub/magnetic-chess/mechanical/Gantry/Bottom.SLDPRT

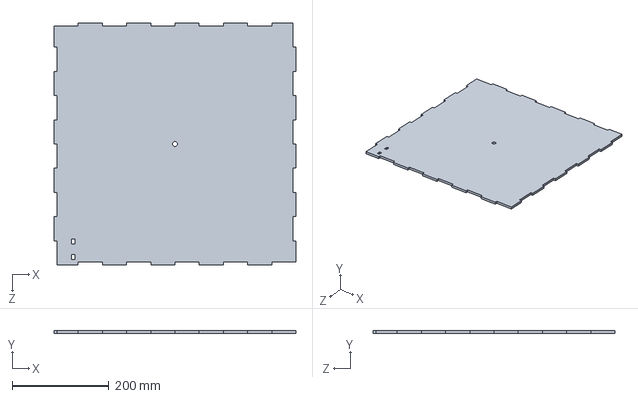
[picture p69: CAD file, 2020-02-17]
mechanical/Gantry/Bottom.SLDPRT
500.0 x 6.35 x 500.0 mm
