ksu-eclub/magnetic-chess/mechanical/Gantry/Linear Bearing Holder.SLDPRT

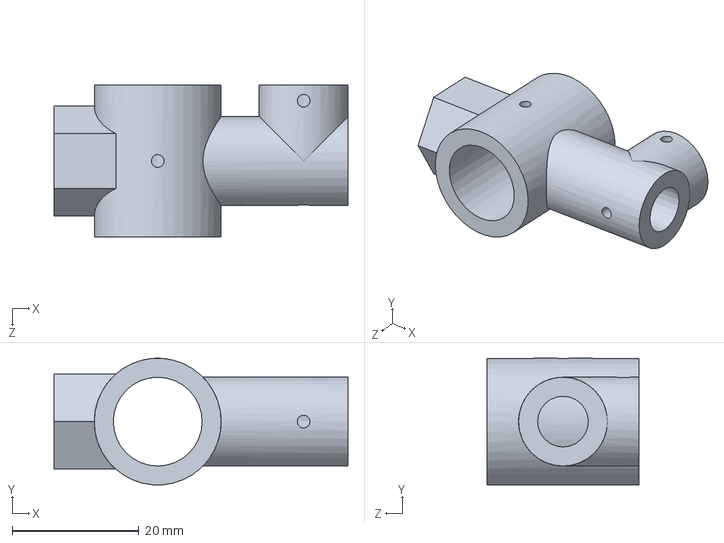
[picture p70: CAD file, 2020-02-17]
mechanical/Gantry/Linear Bearing Holder.SLDPRT
46.3 x 20.0 x 24.0 mm
