ksu-eclub/magnetic-chess/mechanical/Gantry/Clamp Plate.SLDPRT

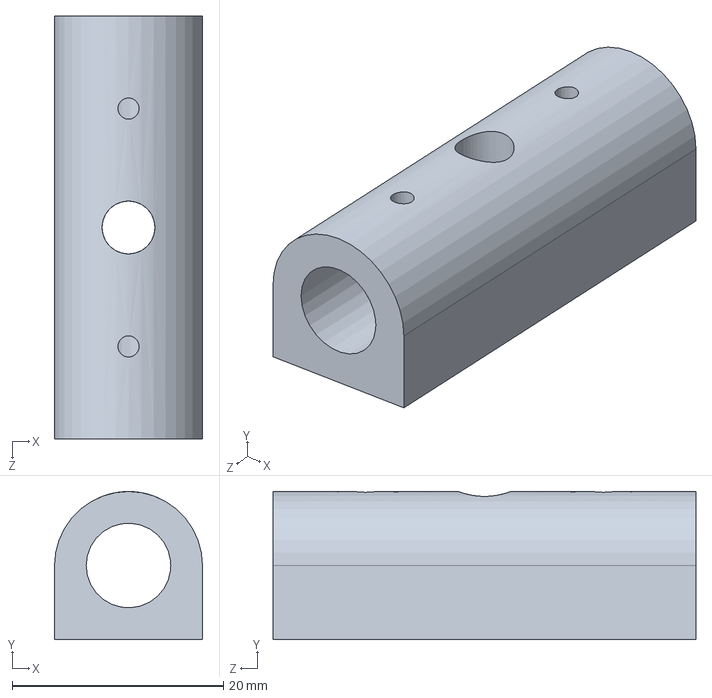
[picture p71: CAD file, 2020-02-17]
mechanical/Gantry/Clamp Plate.SLDPRT
14.0 x 14.0 x 40.0 mm
