ksu-eclub/magnetic-chess/mechanical/Gantry/Pulley.SLDPRT

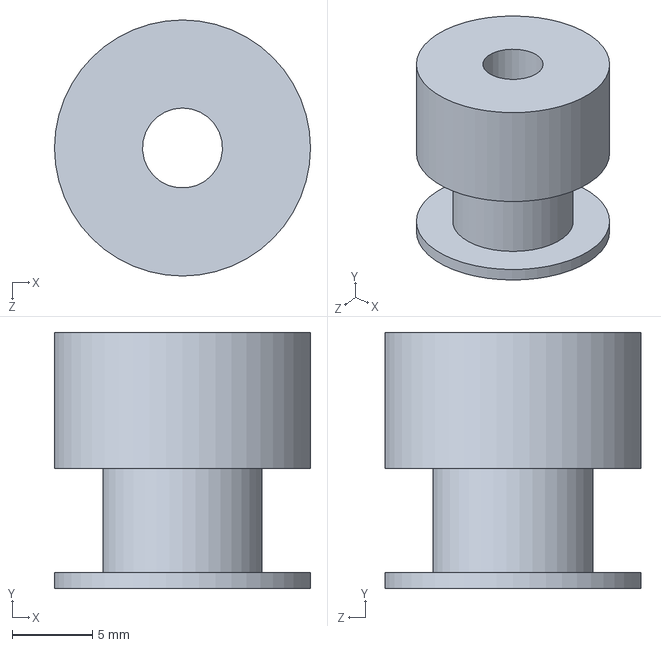
[picture p72: CAD file, 2020-02-17]
mechanical/Gantry/Pulley.SLDPRT
16.0 x 16.0 x 16.0 mm
