ksu-eclub/magnetic-chess/mechanical/Gantry/Clamp.SLDPRT

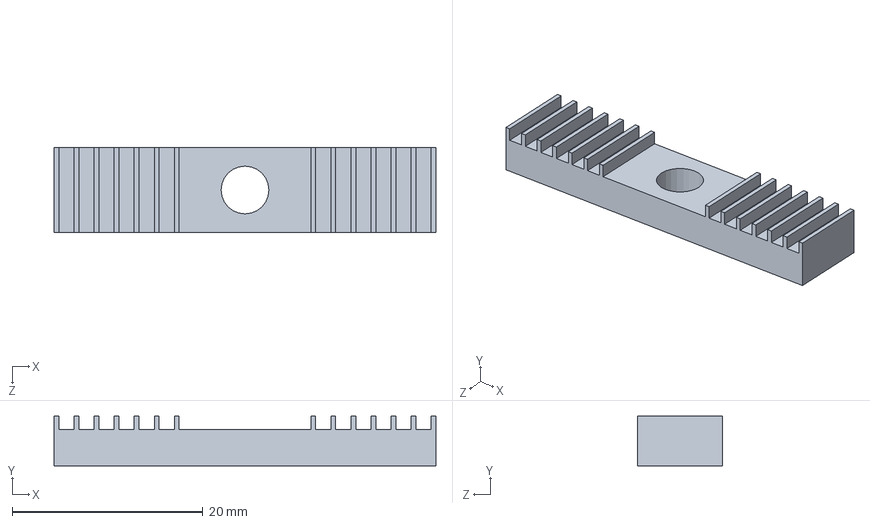
[picture p73: CAD file, 2020-02-17]
mechanical/Gantry/Clamp.SLDPRT
40.0 x 5.20 x 8.90 mm
