ksu-eclub/magnetic-chess/mechanical/Gantry/Side.SLDPRT

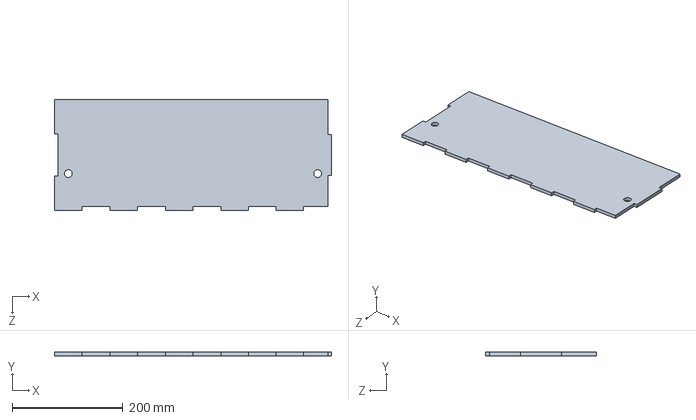
[picture p74: CAD file, 2020-02-17]
mechanical/Gantry/Side.SLDPRT
500.0 x 6.35 x 200.0 mm
