ksu-eclub/magnetic-chess/(list of files, cad)

Other CAD files:
mechanical/3D Printing/Pulley Spacer.STL
mechanical/Gantry/Cross-Axis Support.SLDPRT
mechanical/Box/Fan Mount.SLDPRT
mechanical/Board/LED Module Jig.SLDPRT
mechanical/Drag Chain/Drag Chain Link.STL
mechanical/Gantry/Magnet Holder.SLDPRT
mechanical/Laser-Cutting/0.25in MDF - Magnetic Chess.DXF
mechanical/PCBs/LED Controller.SLDPRT
mechanical/PCBs/LED Module.SLDPRT
mechanical/PCBs/Pi Hat.SLDPRT
mechanical/PCBs/Power Entry.SLDPRT
mechanical/PCBs/magnet driver.SLDPRT
mechanical/PCBs/stepper.SLDPRT
mechanical/Pieces/Bishop.STL
mechanical/Pieces/king.DXF
mechanical/Pieces/knight.STL
mechanical/Pieces/pawn.stl
mechanical/Pieces/queen.STL
mechanical/Pieces/rook.STL
