ksu-eclub/magnetic-chess/electronics/LED Controller.brd

## EAGLE design electronics/LED Controller.brd (2020-02-13)

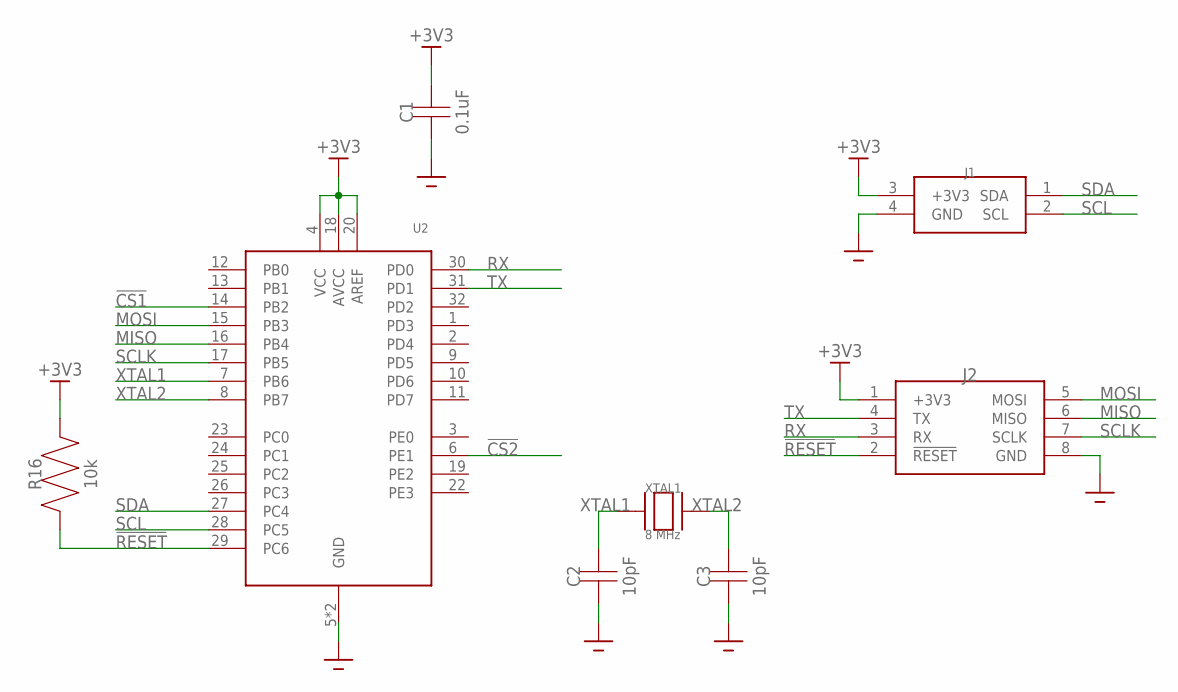
[picture p75: schematic LED Controller.sch, sheet 1, MCU]

Parts:
C1: 0.1uF; 0805
C2, C3: 10pF; 0805
J1: 1-770968-0
J2: DF1BZ-8DP-2.5DSA
R16: 10k; 0805
U2: ATMEGA328PB32-TQFP; ATMEGA328PB
XTAL1: 8 MHz; XRCGB

Connections:
!CS1: U2.14 (PB2); also elsewhere on the board
!CS2: U2.6 (PE1); also elsewhere on the board
!RESET: J2.2 (!RESET), R16.P$1, U2.29 (PC6)
+3V3: C1.P$2, J1.3 (+3V3), J2.1 (+3V3), R16.P$2, U2.4 (VCC), U2.18 (AVCC), U2.20 (AREF); also elsewhere on the board
GND: C1.P$1, C2.P$1, C3.P$1, J1.4 (GND), J2.8 (GND), U2.5 (GND), U2.21 (GND); also elsewhere on the board
MISO: J2.6 (MISO), U2.16 (PB4); also elsewhere on the board
MOSI: J2.5 (MOSI), U2.15 (PB3); also elsewhere on the board
RX: J2.3 (RX), U2.30 (PD0)
SCL: J1.2 (SCL), U2.28 (PC5)
SCLK: J2.7 (SCLK), U2.17 (PB5); also elsewhere on the board
SDA: J1.1 (SDA), U2.27 (PC4)
TX: J2.4 (TX), U2.31 (PD1)
XTAL1: C2.P$2, U2.7 (PB6), XTAL1.1, XTAL1.3
XTAL2: C3.P$2, U2.8 (PB7), XTAL1.2, XTAL1.4

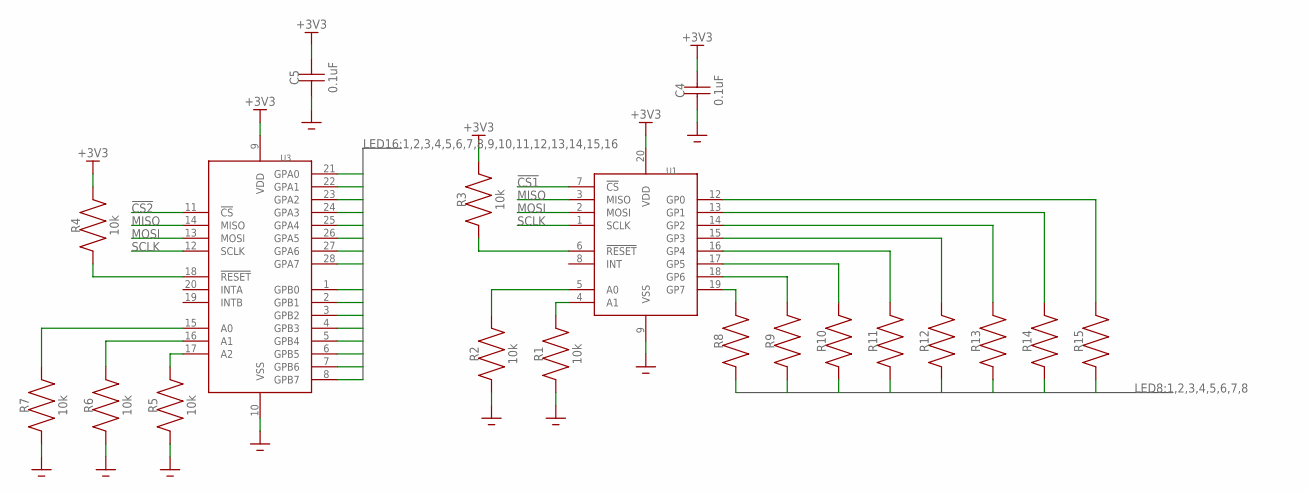
[picture p76: schematic LED Controller.sch, sheet 2, IO Expanders]

Parts:
C4, C5: 0.1uF; 0805
R1, R2, R3, R4, R5, R6, R7: 10k; 0805
R8, R9, R10, R11, R12, R13, R14, R15: RESISTOR0805; 0805
U1: MCP23S08-E/SO
U3: MCP23S17T-E/SO

Connections:
1: U3.21 (GPA0); also elsewhere on the board
2: U3.22 (GPA1); also elsewhere on the board
3: U3.23 (GPA2); also elsewhere on the board
4: U3.24 (GPA3); also elsewhere on the board
5: U3.25 (GPA4); also elsewhere on the board
6: U3.26 (GPA5); also elsewhere on the board
7: U3.27 (GPA6); also elsewhere on the board
8: U3.28 (GPA7); also elsewhere on the board
9: U3.1 (GPB0); also elsewhere on the board
10: U3.2 (GPB1); also elsewhere on the board
11: U3.3 (GPB2); also elsewhere on the board
12: U3.4 (GPB3); also elsewhere on the board
13: U3.5 (GPB4); also elsewhere on the board
14: U3.6 (GPB5); also elsewhere on the board
15: U3.7 (GPB6); also elsewhere on the board
16: U3.8 (GPB7); also elsewhere on the board
!CS1: U1.7 (!CS); also elsewhere on the board
!CS2: U3.11 (!CS); also elsewhere on the board
+3V3: C4.P$2, C5.P$2, R3.P$2, R4.P$2, U1.20 (VDD), U3.9 (VDD); also elsewhere on the board
A: R15.P$1; also elsewhere on the board
B: R14.P$1; also elsewhere on the board
C: R13.P$1; also elsewhere on the board
D: R12.P$1; also elsewhere on the board
E: R11.P$1; also elsewhere on the board
F: R10.P$1; also elsewhere on the board
G: R9.P$1; also elsewhere on the board
GND: C4.P$1, C5.P$1, R1.P$1, R2.P$1, R5.P$1, R6.P$1, R7.P$1, U1.9 (VSS), U3.10 (VSS); also elsewhere on the board
H: R8.P$1; also elsewhere on the board
MISO: U1.3 (MISO), U3.14 (MISO); also elsewhere on the board
MOSI: U1.2 (MOSI), U3.13 (MOSI); also elsewhere on the board
unnamed: R1.P$2, U1.4 (A1)
unnamed: R2.P$2, U1.5 (A0)
unnamed: R3.P$1, U1.6 (!RESET)
unnamed: R4.P$1, U3.18 (!RESET)
unnamed: R5.P$2, U3.17 (A2)
unnamed: R6.P$2, U3.16 (A1)
unnamed: R7.P$2, U3.15 (A0)
unnamed: R8.P$2, U1.19 (GP7)
unnamed: R9.P$2, U1.18 (GP6)
unnamed: R10.P$2, U1.17 (GP5)
unnamed: R11.P$2, U1.16 (GP4)
unnamed: R12.P$2, U1.15 (GP3)
unnamed: R13.P$2, U1.14 (GP2)
unnamed: R14.P$2, U1.13 (GP1)
unnamed: R15.P$2, U1.12 (GP0)
SCLK: U1.1 (SCLK), U3.12 (SCLK); also elsewhere on the board

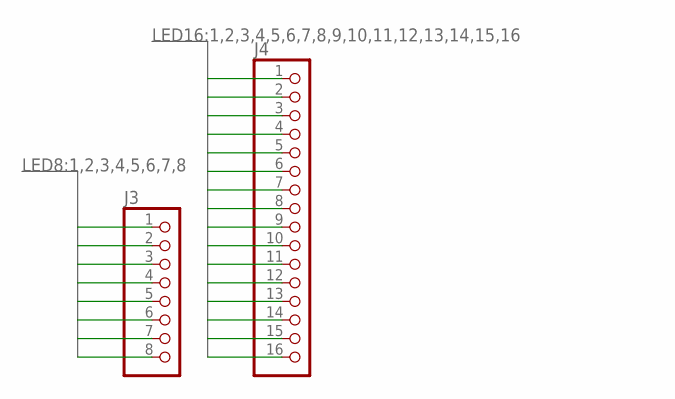
[picture p77: schematic LED Controller.sch, sheet 3, Interface]

Parts:
J3: LED8
J4: LED16

Connections:
1: J4.1; also elsewhere on the board
2: J4.2; also elsewhere on the board
3: J4.3; also elsewhere on the board
4: J4.4; also elsewhere on the board
5: J4.5; also elsewhere on the board
6: J4.6; also elsewhere on the board
7: J4.7; also elsewhere on the board
8: J4.8; also elsewhere on the board
9: J4.9; also elsewhere on the board
10: J4.10; also elsewhere on the board
11: J4.11; also elsewhere on the board
12: J4.12; also elsewhere on the board
13: J4.13; also elsewhere on the board
14: J4.14; also elsewhere on the board
15: J4.15; also elsewhere on the board
16: J4.16; also elsewhere on the board
A: J3.1; also elsewhere on the board
B: J3.2; also elsewhere on the board
C: J3.3; also elsewhere on the board
D: J3.4; also elsewhere on the board
E: J3.5; also elsewhere on the board
F: J3.6; also elsewhere on the board
G: J3.7; also elsewhere on the board
H: J3.8; also elsewhere on the board

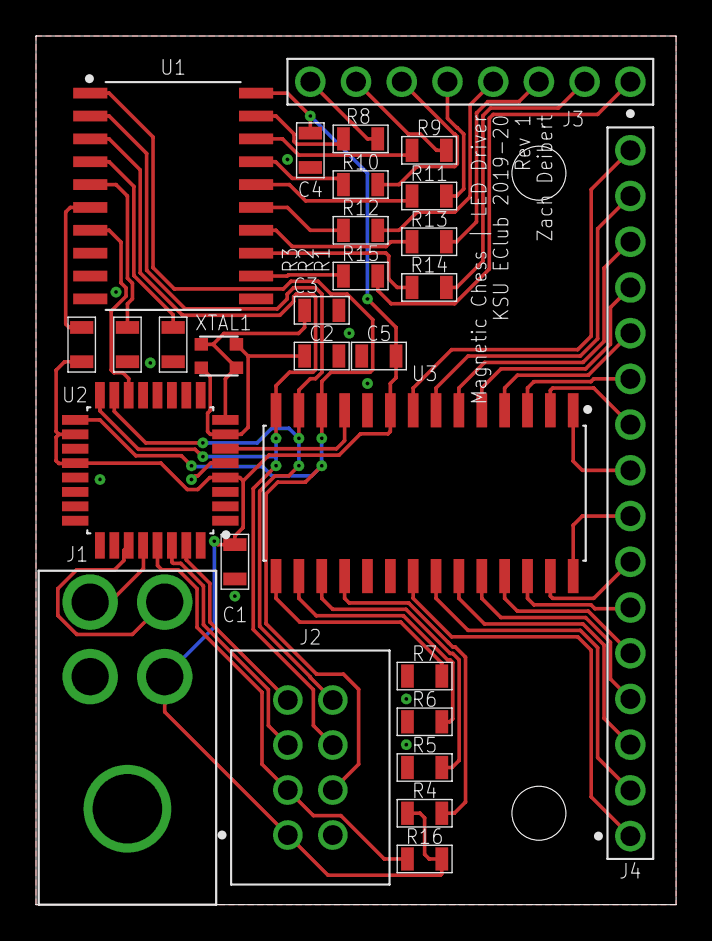
[picture p78: board LED Controller.brd from above]

Board: 2 copper layers, 35.6 x 48.3 mm, 29 parts (0 on the bottom side), 53 nets.
