ksu-eclub/magnetic-chess/electronics/magnet driver.brd

## EAGLE design electronics/magnet driver.brd (2020-02-13)

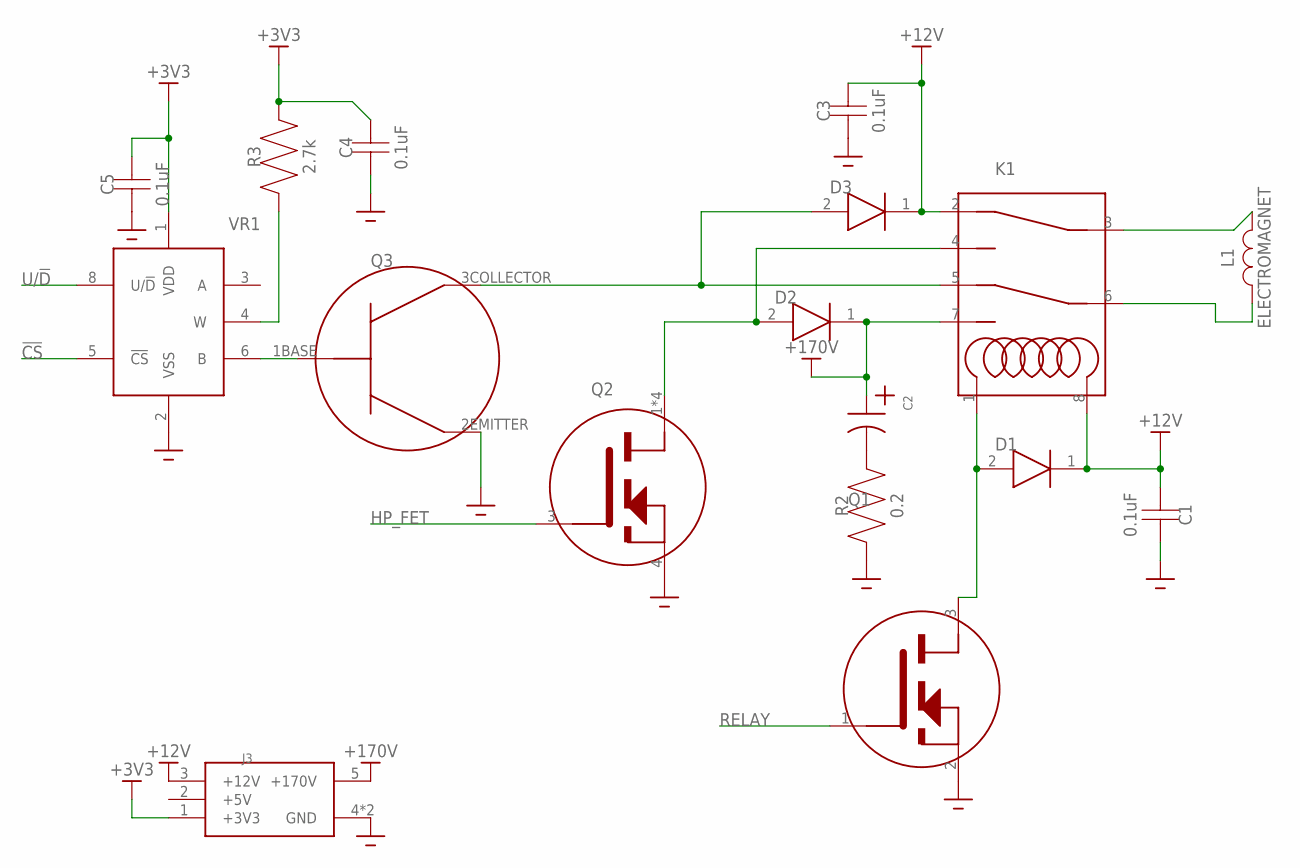
[picture p79: schematic magnet driver.sch, sheet 1]

Parts:
C1, C3, C4, C5: 0.1uF; 0805
C2: ESMQ351VSN102MA50S
D1, D2, D3: BAT54HT1GBAT54HT1G; SOD2512X110N
J3: 1-770969-0
K1: G2RL-2DC12
L1: ELECTROMAGNET
Q1: RK7002BMT116; SOT95P240X120-3N
Q2: DMN1019UVT-7DMN1019UVT-7; SOT95P280X100-6N
Q3: PMBT2222A,215PMBT2222A,215; SOT95P230X110-3N
R2: 0.2; 0805
R3: 2.7k; 0805
VR1: MCP4011-103E/MSMCP4011-103E/MS; SOP65P490X265-8N

Connections:
!CS: VR1.5 (!CS); also elsewhere on the board
+3V3: C4.P$2, C5.P$2, J3.1 (+3V3), R3.P$2, VR1.1 (VDD); also elsewhere on the board
+5V: J3.2 (+5V)
+12V: C1.P$1, C3.P$2, D1.1 (CATHODE(1)), D3.1 (CATHODE(1)), J3.3 (+12V), K1.2 (A1), K1.8 (COILOUT)
+170V: C2.+, D2.1 (CATHODE(1)), J3.5 (+170V), K1.7 (B2)
GND: C1.P$2, C3.P$1, C4.P$1, C5.P$1, J3.4 (GND), J3.6 (GND), Q1.2 (SOURCE(2)), Q2.4 (SOURCE(2)), Q3.2EMITTER (2E), R2.P$1, VR1.2 (VSS); also elsewhere on the board
HP_FET: Q2.3 (GATE(1)); also elsewhere on the board
unnamed: K1.3 (A), L1.-
unnamed: C2.-, R2.P$2
unnamed: D1.2 (ANODE(2)), K1.1 (COILIN), Q1.3 (DRAIN(3))
unnamed: K1.6 (B), L1.+
unnamed: Q3.1BASE (1B), VR1.6 (B)
unnamed: R3.P$1, VR1.4 (W)
unnamed: D3.2 (ANODE(2)), K1.5 (B1), Q3.3COLLECTOR (3C)
unnamed: D2.2 (ANODE(2)), K1.4 (A2), Q2.1 (DRAIN(3)), Q2.2 (DRAIN(3)), Q2.5 (DRAIN(3)), Q2.6 (DRAIN(3))
RELAY: Q1.1 (GATE(1)); also elsewhere on the board
U/!D: VR1.8 (U/!D); also elsewhere on the board

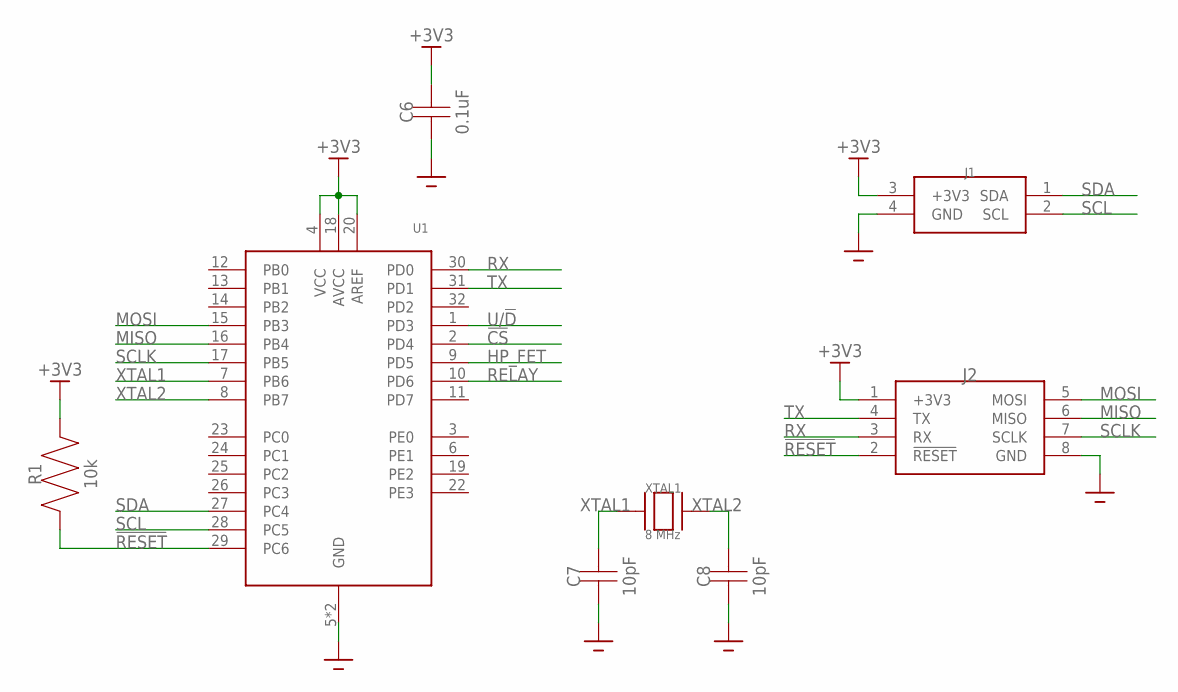
[picture p80: schematic magnet driver.sch, sheet 2]

Parts:
C6: 0.1uF; 0805
C7, C8: 10pF; 0805
J1: 1-770968-0
J2: DF1BZ-8DP-2.5DSA
R1: 10k; 0805
U1: ATMEGA328PB32-TQFP; ATMEGA328PB
XTAL1: 8 MHz; XRCGB

Connections:
!CS: U1.2 (PD4); also elsewhere on the board
!RESET: J2.2 (!RESET), R1.P$1, U1.29 (PC6)
+3V3: C6.P$2, J1.3 (+3V3), J2.1 (+3V3), R1.P$2, U1.4 (VCC), U1.18 (AVCC), U1.20 (AREF); also elsewhere on the board
GND: C6.P$1, C7.P$1, C8.P$1, J1.4 (GND), J2.8 (GND), U1.5 (GND), U1.21 (GND); also elsewhere on the board
HP_FET: U1.9 (PD5); also elsewhere on the board
MISO: J2.6 (MISO), U1.16 (PB4)
MOSI: J2.5 (MOSI), U1.15 (PB3)
RELAY: U1.10 (PD6); also elsewhere on the board
RX: J2.3 (RX), U1.30 (PD0)
SCL: J1.2 (SCL), U1.28 (PC5)
SCLK: J2.7 (SCLK), U1.17 (PB5)
SDA: J1.1 (SDA), U1.27 (PC4)
TX: J2.4 (TX), U1.31 (PD1)
U/!D: U1.1 (PD3); also elsewhere on the board
XTAL1: C7.P$2, U1.7 (PB6), XTAL1.1, XTAL1.3
XTAL2: C8.P$2, U1.8 (PB7), XTAL1.2, XTAL1.4

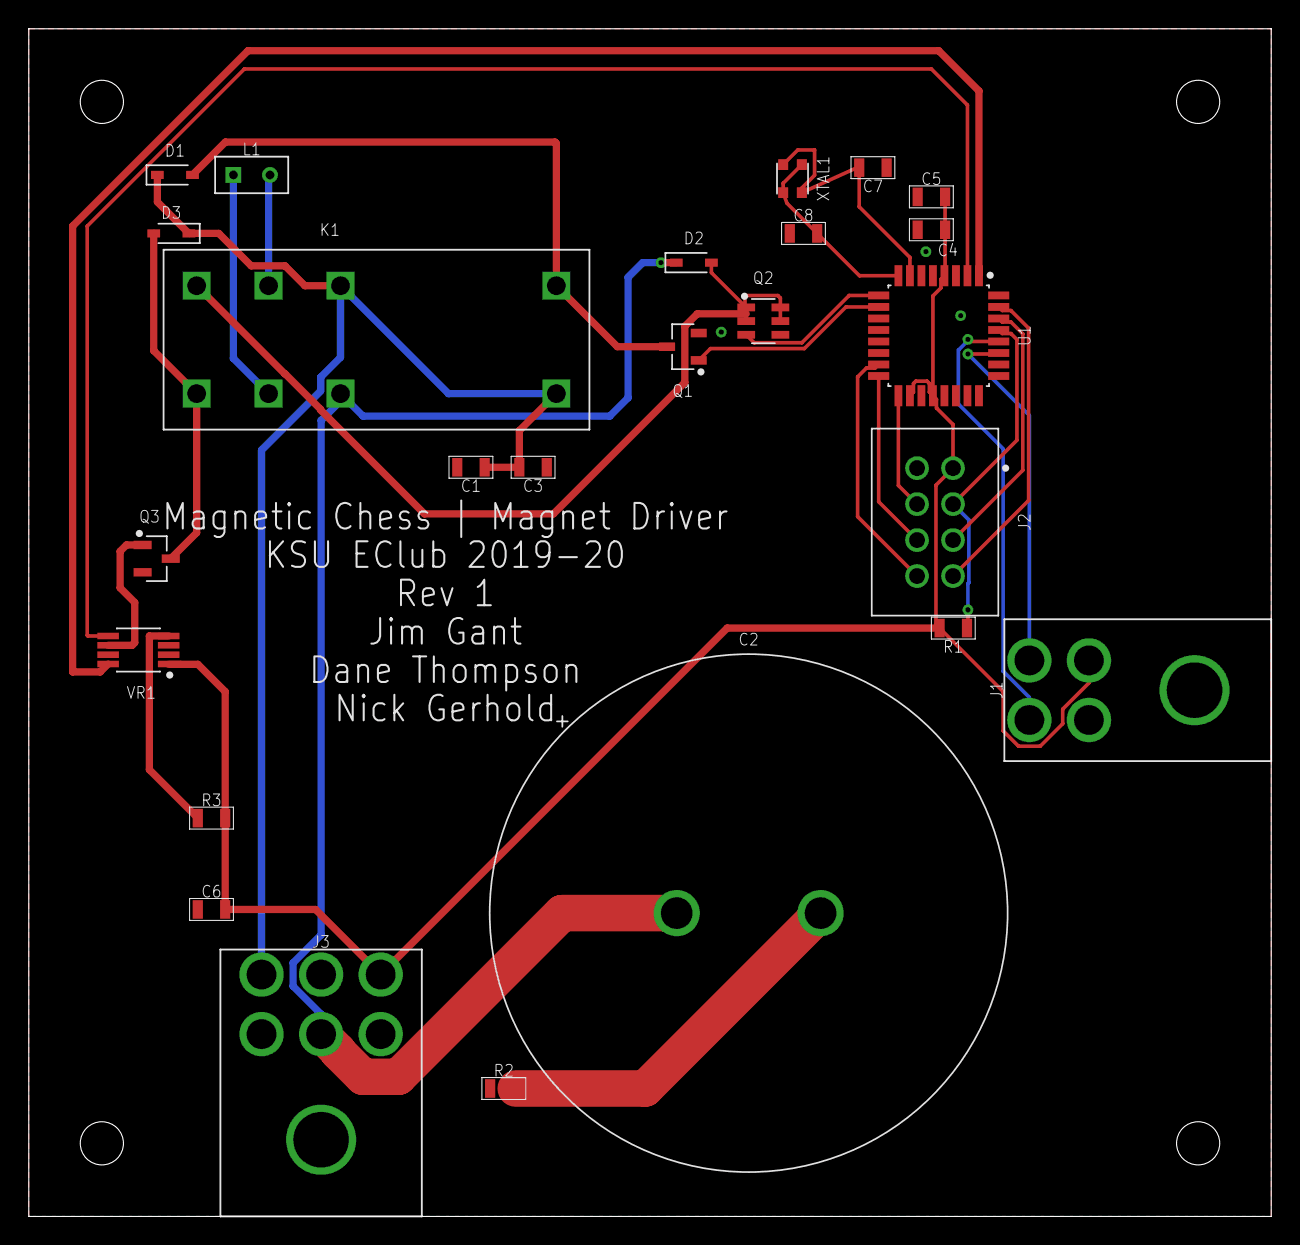
[picture p81: board magnet driver.brd from above]

Board: 2 copper layers, 86.4 x 82.5 mm, 25 parts (0 on the bottom side), 26 nets.
