ksu-eclub/magnetic-chess/electronics/Power Entry.brd

## EAGLE design electronics/Power Entry.brd (2020-02-13)

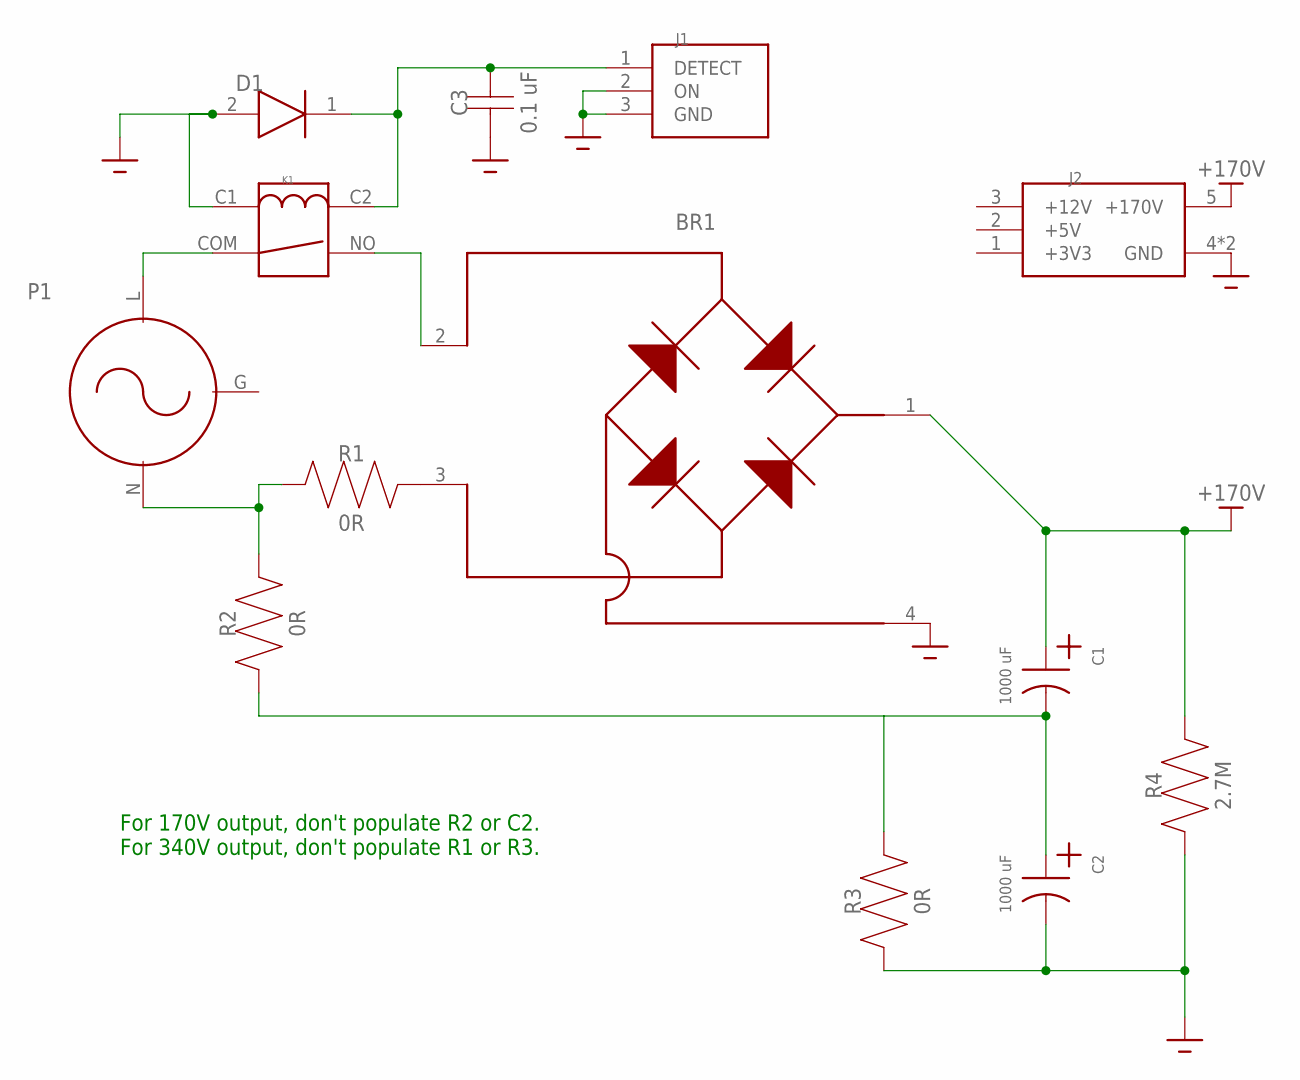
[picture p82: schematic Power Entry.sch]

Parts:
BR1: GBJ1004-BP
C1, C2: 1000 uF; ESMQ351VSN102MA50S
C3: 0.1 uF; 0805
D1: BAT54HT1GBAT54HT1G; SOD2512X110N
J1: 1-770967-0
J2: 1-770969-0
K1: ALQ3F12
P1: 703W-00/04
R1, R2, R3: 0R; 0805
R4: 2.7M; 0805

Connections:
+3V3: J2.1 (+3V3)
+5V: J2.2 (+5V)
+12V: J2.3 (+12V)
+170V: BR1.1 (POSITIVE_DC), C1.+, J2.5 (+170V), R4.P$2
GND: BR1.4 (NEGATIVE_DC), C2.-, C3.P$1, D1.2 (ANODE(2)), J1.2 (ON), J1.3 (GND), J2.4 (GND), J2.6 (GND), K1.C1, R3.P$1, R4.P$1
unnamed: BR1.3 (AC_IN2), R1.P$2
unnamed: P1.N (NEUTRAL), R1.P$1, R2.P$2
unnamed: C1.-, C2.+, R2.P$1, R3.P$2
unnamed: K1.COM (S1), P1.L (LIVE)
unnamed: BR1.2 (AC_IN1), K1.NO (S2)
unnamed: C3.P$2, D1.1 (CATHODE(1)), J1.1 (DETECT), K1.C2

Notes on the sheet:
For 170V output, don't populate R2 or C2. For 340V output, don't populate R1 or R3.

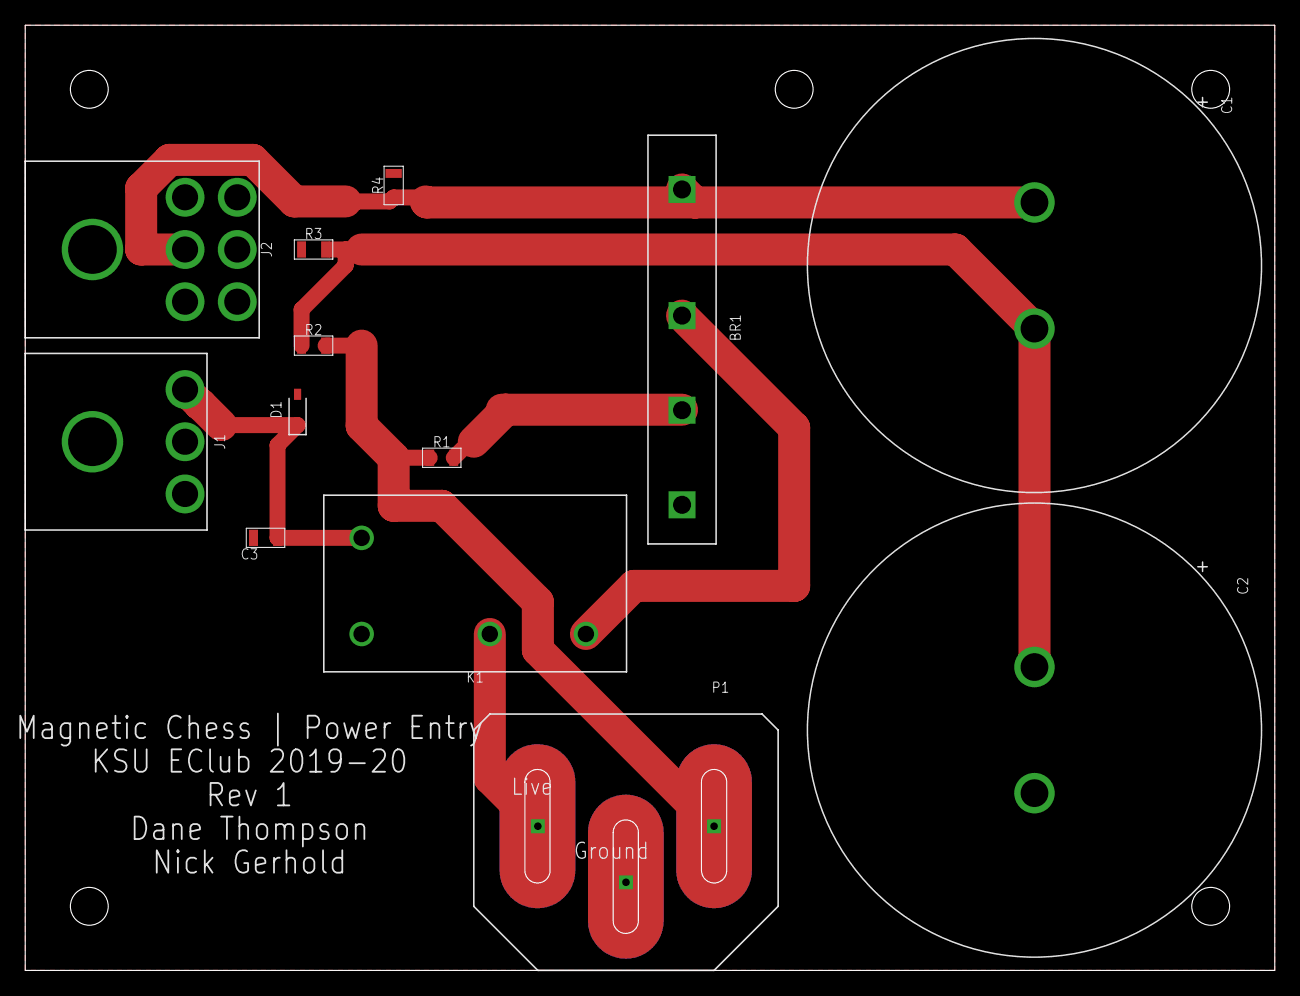
[picture p83: board Power Entry.brd from above]

Board: 2 copper layers, 99.1 x 74.9 mm, 13 parts (0 on the bottom side), 8 nets.
