ksu-eclub/magnetic-chess/electronics/stepper.brd

## EAGLE design electronics/stepper.brd (2020-02-13)

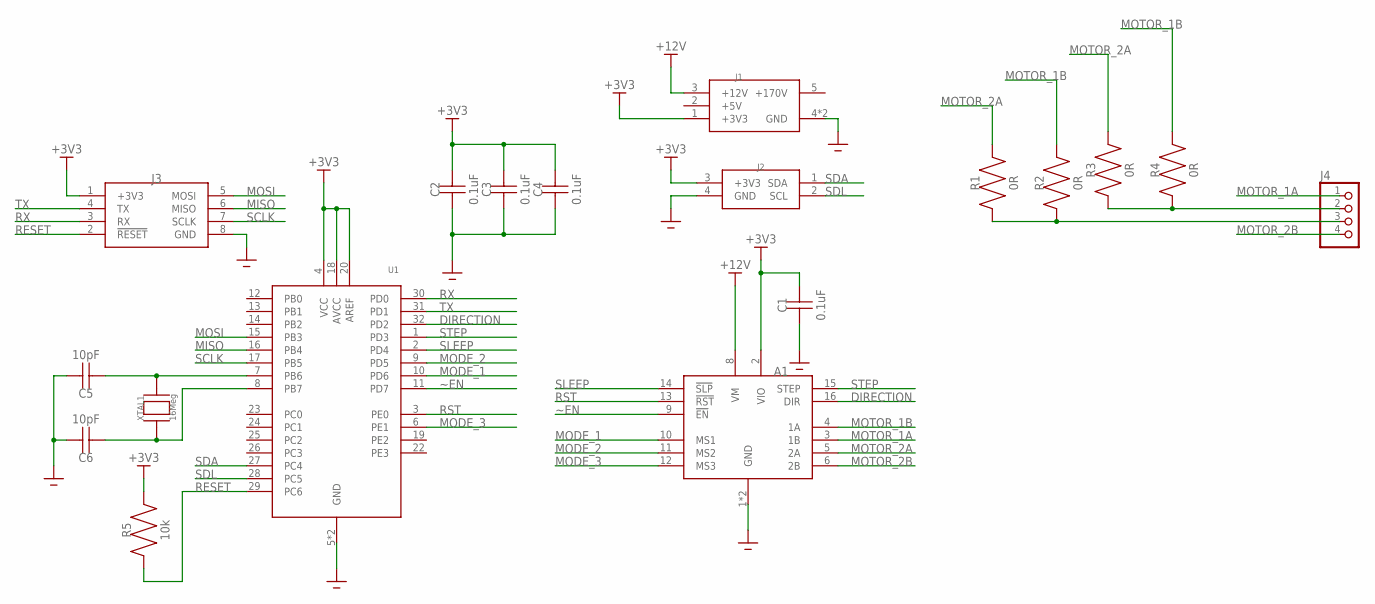
[picture p84: schematic stepper.sch, Stepper Driver Schematic]

Parts:
A1: STEPPER_DRIVER
C1, C2, C3, C4: 0.1uF; 0402
C5, C6: 10pF; 0402
J1: 1-770969-0
J2: 1-770968-0
J3: DF1BZ-8DP-2.5DSA
J4: S4B-XH-A
R1, R2, R3, R4: 0R; 0402
R5: 10k; 0402
U1: ATMEGA328PB32-TQFP; ATMEGA328PB
XTAL1: 16Meg; XRCGB

Connections:
+3V3: A1.2 (VIO), C1.2, C2.2, C3.2, C4.2, J1.1 (+3V3), J2.3 (+3V3), J3.1 (+3V3), R5.2, U1.4 (VCC), U1.18 (AVCC), U1.20 (AREF)
+5V: J1.2 (+5V)
+12V: A1.8 (VM), J1.3 (+12V)
+170V: J1.5 (+170V)
DIRECTION: A1.16 (DIR), U1.32 (PD2)
GND: A1.1 (GND), A1.7 (GND), C1.1, C2.1, C3.1, C4.1, C5.2, C6.2, J1.4 (GND), J1.6 (GND), J2.4 (GND), J3.8 (GND), U1.5 (GND), U1.21 (GND)
MISO: J3.6 (MISO), U1.16 (PB4)
MODE_1: A1.10 (MS1), U1.10 (PD6)
MODE_2: A1.11 (MS2), U1.9 (PD5)
MODE_3: A1.12 (MS3), U1.6 (PE1)
MOSI: J3.5 (MOSI), U1.15 (PB3)
MOTOR_1A: A1.3 (1B), J4.1
MOTOR_1B: A1.4 (1A), R2.2, R4.2
MOTOR_2A: A1.5 (2A), R1.2, R3.2
MOTOR_2B: A1.6 (2B), J4.4
unnamed: C5.1, U1.7 (PB6), XTAL1.2, XTAL1.4
unnamed: C6.1, U1.8 (PB7), XTAL1.1, XTAL1.3
unnamed: J4.2, R3.1, R4.1
unnamed: J4.3, R1.1, R2.1
RESET: J3.2 (!RESET), R5.1, U1.29 (PC6)
RST: A1.13 (!RST), U1.3 (PE0)
RX: J3.3 (RX), U1.30 (PD0)
SCLK: J3.7 (SCLK), U1.17 (PB5)
SDA: J2.1 (SDA), U1.27 (PC4)
SDL: J2.2 (SCL), U1.28 (PC5)
SLEEP: A1.14 (!SLP), U1.2 (PD4)
STEP: A1.15 (STEP), U1.1 (PD3)
TX: J3.4 (TX), U1.31 (PD1)
~EN: A1.9 (!EN), U1.11 (PD7)

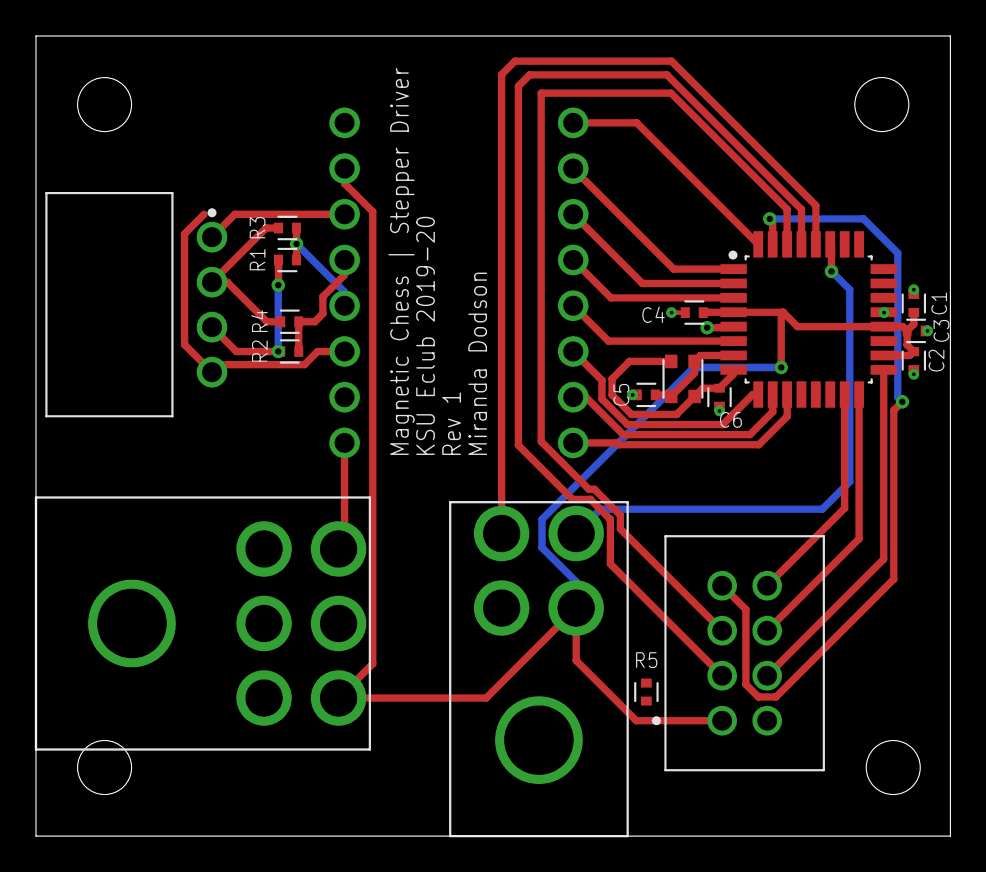
[picture p85: board stepper.brd from above]

Board: 2 copper layers, 50.8 x 44.5 mm, 18 parts (1 on the bottom side), 27 nets.
