ksu-eclub/magnetic-chess/electronics/LED Module.brd

## EAGLE design electronics/LED Module.brd (2020-02-11)

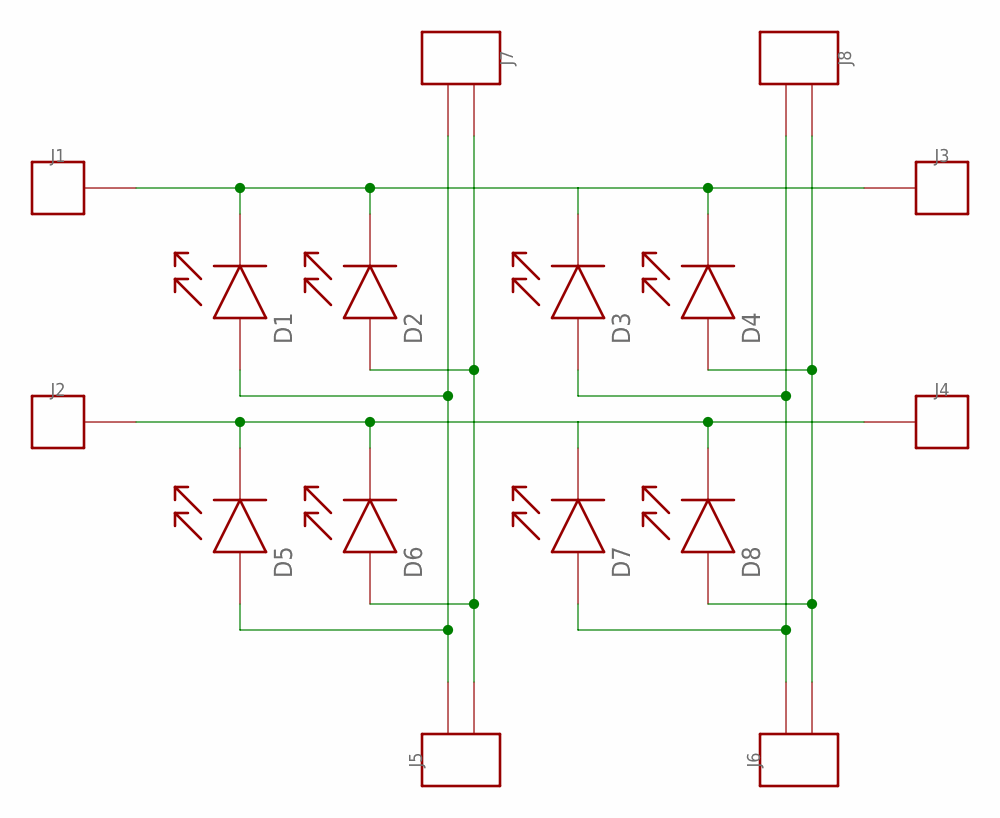
[picture p86: schematic LED Module.sch]

Parts:
D1, D2, D3, D4, D5, D6, D7, D8: LED; 0805-POL
J1, J2, J3, J4: LED_JUMPER_1
J5, J6, J7, J8: LED_JUMPER_2

Connections:
unnamed: D1.+ (K), D2.+ (K), D3.+ (K), D4.+ (K), J1.1, J3.1
unnamed: D1.COM (A), D5.COM (A), J5.1, J7.2
unnamed: D2.COM (A), D6.COM (A), J5.2, J7.1
unnamed: D5.+ (K), D6.+ (K), D7.+ (K), D8.+ (K), J2.1, J4.1
unnamed: D3.COM (A), D7.COM (A), J6.1, J8.2
unnamed: D4.COM (A), D8.COM (A), J6.2, J8.1

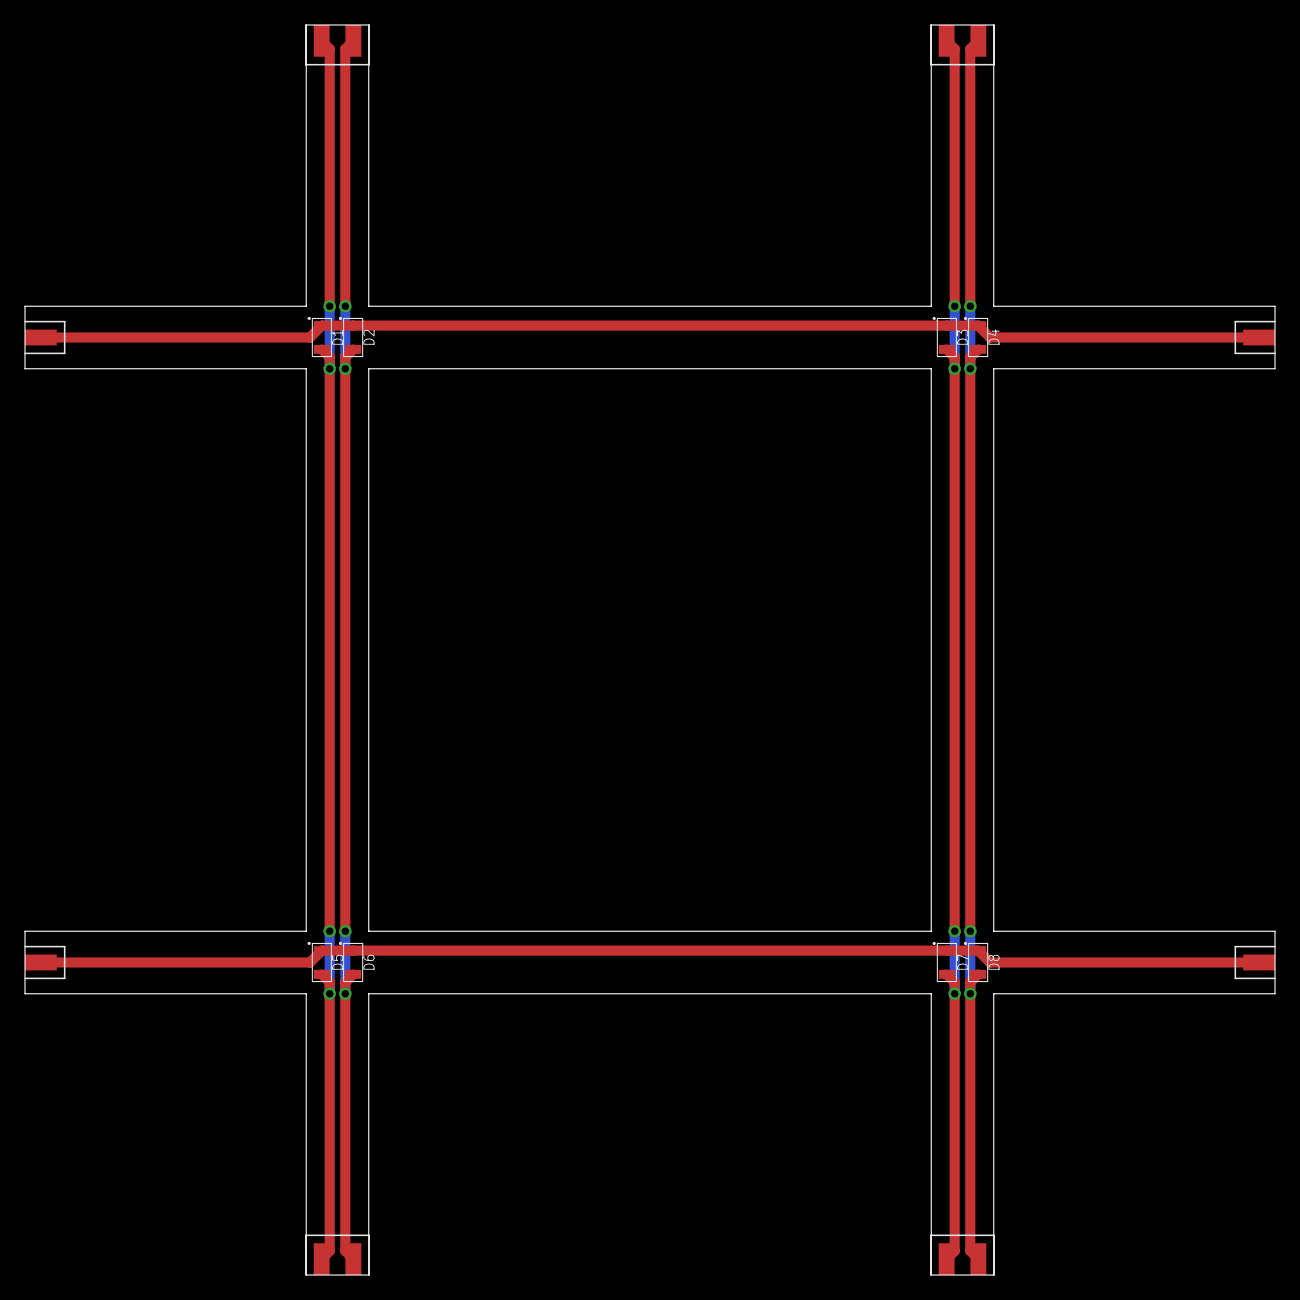
[picture p87: board LED Module.brd from above]

Board: 2 copper layers, 100.0 x 100.0 mm, 16 parts (0 on the bottom side), 6 nets.
