ksu-eclub/magnetic-chess/electronics/Pi Hat.brd

## EAGLE design electronics/Pi Hat.brd (2020-02-11)

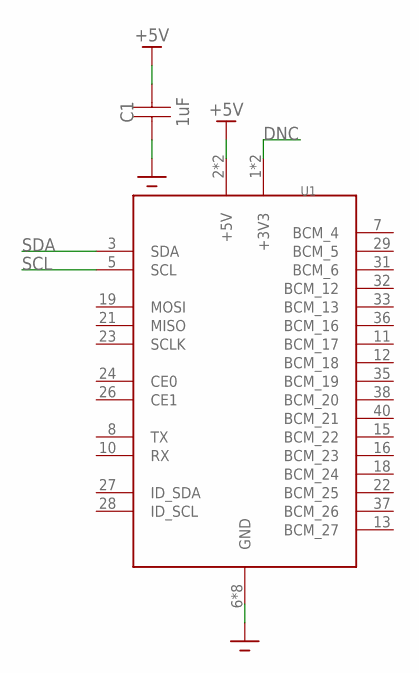
[picture p88: schematic Pi Hat.sch, sheet 1, Pi]

Parts:
C1: 1uF; 0805
U1: RPI

Connections:
+5V: C1.P$2, U1.2 (+5V), U1.4 (+5V); also elsewhere on the board
DNC: U1.1 (+3V3), U1.17 (+3V3)
GND: C1.P$1, U1.6 (GND), U1.9 (GND), U1.14 (GND), U1.20 (GND), U1.25 (GND), U1.30 (GND), U1.34 (GND), U1.39 (GND); also elsewhere on the board
SCL: U1.5 (SCL); also elsewhere on the board
SDA: U1.3 (SDA); also elsewhere on the board

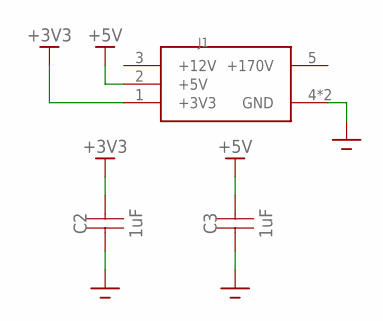
[picture p89: schematic Pi Hat.sch, sheet 2, Power]

Parts:
C2, C3: 1uF; 0805
J1: 1-770969-0

Connections:
+3V3: C2.P$2, J1.1 (+3V3); also elsewhere on the board
+5V: C3.P$2, J1.2 (+5V); also elsewhere on the board
+12V: J1.3 (+12V)
+170V: J1.5 (+170V)
GND: C2.P$1, C3.P$1, J1.4 (GND), J1.6 (GND); also elsewhere on the board

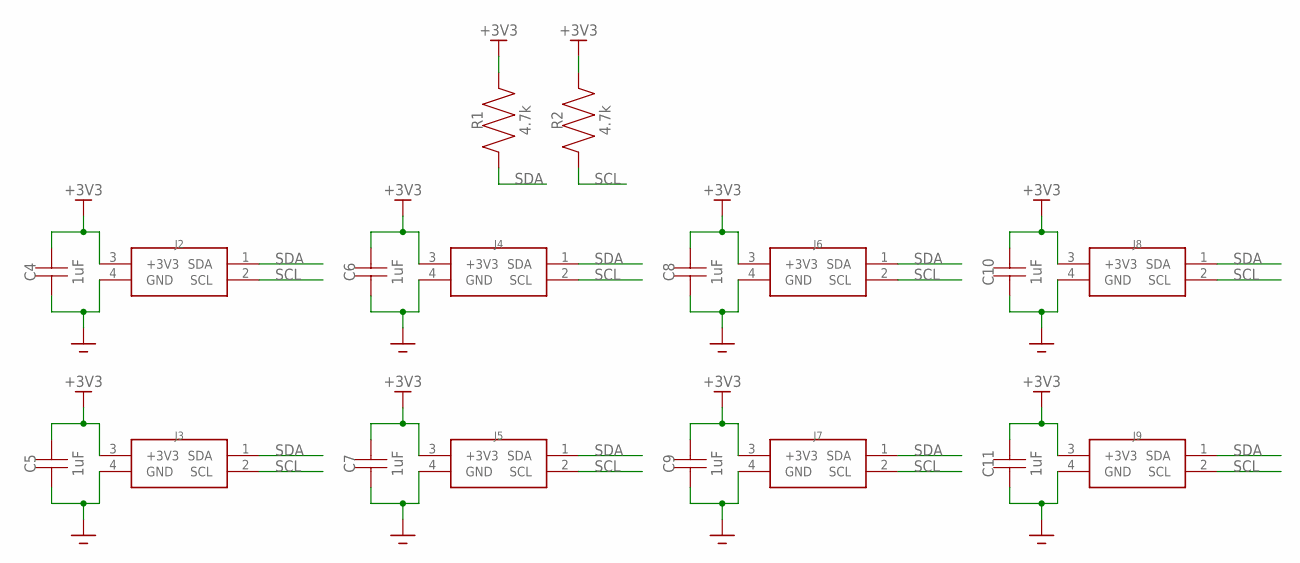
[picture p90: schematic Pi Hat.sch, sheet 3, I2C]

Parts:
C4, C5, C6, C7, C8, C9, C10, C11: 1uF; 0805
J2, J3, J4, J5, J6, J7, J8, J9: 1-770968-0
R1, R2: 4.7k; 0805

Connections:
+3V3: C4.P$2, C5.P$2, C6.P$2, C7.P$2, C8.P$2, C9.P$2, C10.P$2, C11.P$2, J2.3 (+3V3), J3.3 (+3V3), J4.3 (+3V3), J5.3 (+3V3), J6.3 (+3V3), J7.3 (+3V3), J8.3 (+3V3), J9.3 (+3V3), R1.P$2, R2.P$2; also elsewhere on the board
GND: C4.P$1, C5.P$1, C6.P$1, C7.P$1, C8.P$1, C9.P$1, C10.P$1, C11.P$1, J2.4 (GND), J3.4 (GND), J4.4 (GND), J5.4 (GND), J6.4 (GND), J7.4 (GND), J8.4 (GND), J9.4 (GND); also elsewhere on the board
SCL: J2.2 (SCL), J3.2 (SCL), J4.2 (SCL), J5.2 (SCL), J6.2 (SCL), J7.2 (SCL), J8.2 (SCL), J9.2 (SCL), R2.P$1; also elsewhere on the board
SDA: J2.1 (SDA), J3.1 (SDA), J4.1 (SDA), J5.1 (SDA), J6.1 (SDA), J7.1 (SDA), J8.1 (SDA), J9.1 (SDA), R1.P$1; also elsewhere on the board
