ksu-eclub/magnetic-chess/electronics/Pi Hat.brd

## EAGLE design electronics/Pi Hat.brd (continued)

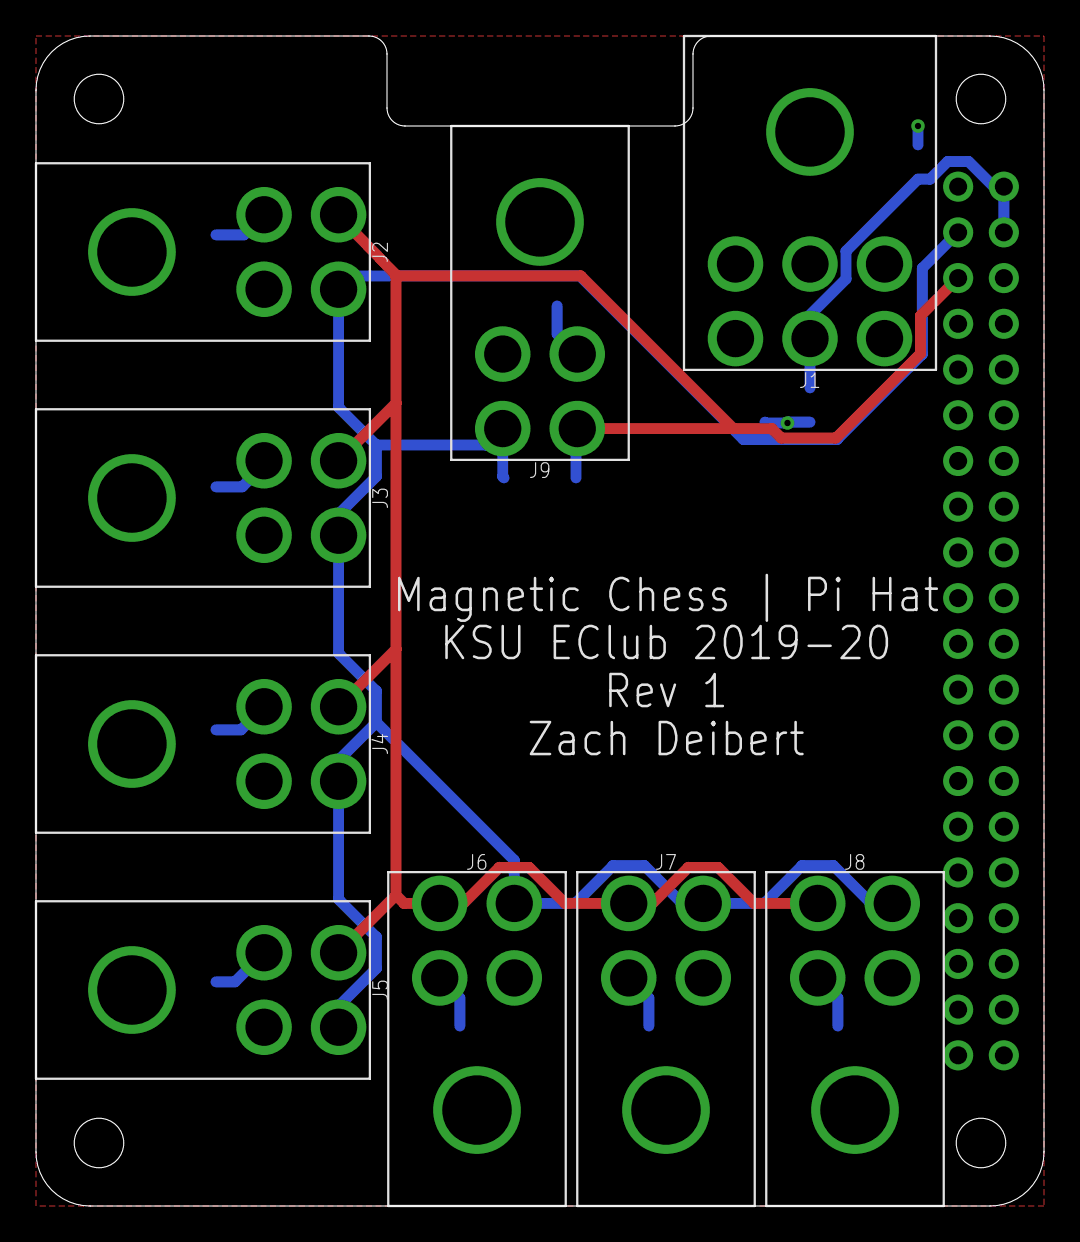
[picture p91: board Pi Hat.brd from above]

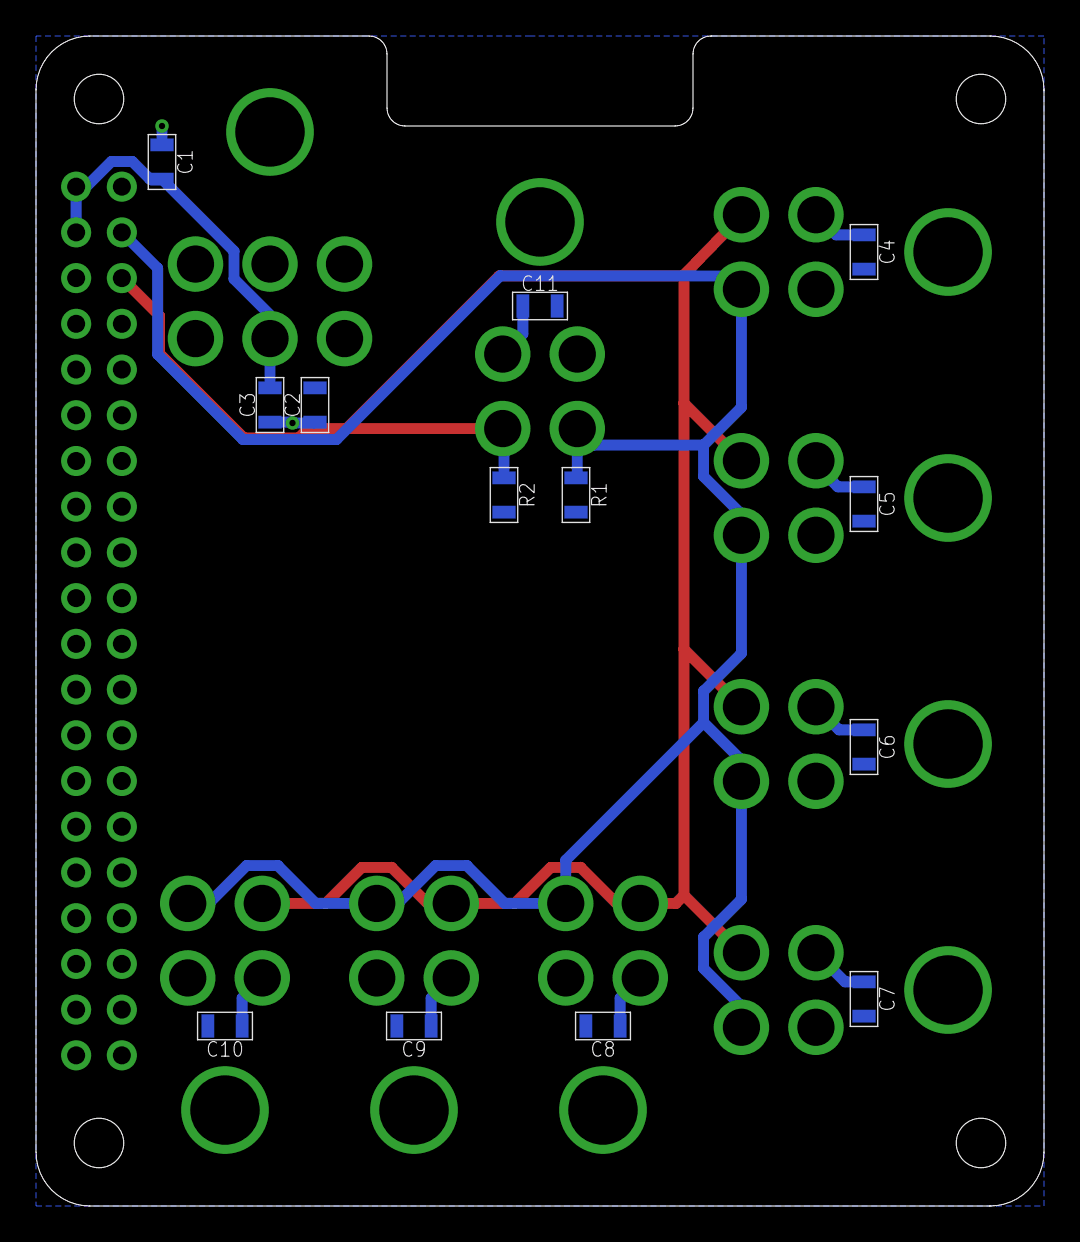
[picture p92: board Pi Hat.brd from below]

Board: 2 copper layers, 56.0 x 65.0 mm, 23 parts (13 on the bottom side), 6 nets.
