ksu-eclub/magnetic-chess/hardware-drivers/magnet_driver/magnet_driver.ino

#include <Wire.h>

#define SERIAL_BAUD 115200
#define SLAVE_ADDRESS 0x02
#define MAGNET_PIN 

void on_request(void);
void on_receive(int count);

void setup(void) {
    Wire.begin(SLAVE_ADDRESS);
    Wire.onRequest(on_request);
    Wire.onReceive(on_receive);
    Serial.begin(SERIAL_BAUD);
    pinMode(MAGNET_PIN,OUTPUT);
}

void loop(void) {
    if (Serial.available()) {
    }
}

void on_request(void) {
}

void on_receive(int count) {
}
