ksu-eclub/magnetic-chess/(commit log)

2019-12-11 I made a relay, Digi Pot, and BJT
2019-12-11 made symbols for rectifier, diode, and n-channel MOSFET
2019-12-13 added Miranda.lbr; added stepper part
2020-01-01 Added power symbols
2020-01-01 started stepper schematic
    [stepper.sch]
2020-01-03 Created connector parts
2020-01-27 Imported stepper driver from other project
2020-01-28 Everything on the stepper driver schematic except the JST connectors for the motors
    [stepper.sch]
2020-01-29 Added some connectors
2020-02-11 Stepper schematic is done. Ready for checkover
    [stepper.sch]
2020-02-11 Fixed capacitor mapping
2020-02-11 Added relay
2020-02-11 Create magnet driver.sch
    [magnet driver.sch]
2020-02-11 power entry started
    [Power Entry.brd, Power Entry.sch]
2020-02-11 Routing crap
    [stepper.brd, stepper.sch]
2020-02-11 Added MCU
    [magnet driver.sch]
2020-02-11 Created Pi hat board
    [Pi Hat.brd, Pi Hat.sch]
2020-02-11 Created LED module board
    [LED Module.brd, LED Module.sch]
2020-02-12 Finished stepper layout.
    [stepper.brd, stepper.sch]
2020-02-12 Created LED controller PCB
    [LED Controller.brd, LED Controller.sch]
2020-02-12 Made board ID consistent
    [stepper.brd]
2020-02-12 Added board ID
    [Power Entry.brd]
2020-02-12 Finished magnet driver schematic
    [magnet driver.brd, magnet driver.sch]
2020-02-12 Added current-limiting resistors for LEDs
    [LED Controller.brd, LED Controller.sch]
2020-02-12 Added pull-up on RESET
    [LED Controller.brd, LED Controller.sch, magnet driver.brd, magnet driver.sch]
2020-02-12 Update Power Entry.brd
    [Power Entry.brd]
2020-02-12 Update magnet driver.brd
    [magnet driver.brd]
2020-02-12 Update magnet driver.sch
    [magnet driver.sch]
2020-02-13 finished stepper
    [stepper.brd, stepper.sch]
2020-02-13 Fixed some problems with the magnet driver board
    [magnet driver.brd]
2020-02-13 Added mounting holes
    [LED Controller.brd, Power Entry.brd, magnet driver.brd]
2020-02-17 Initial check-in of SolidWorks files
    [Axle.SLDPRT, Bearing.SLDPRT, Belt.SLDPRT, Bottom.SLDPRT, Clamp Plate.SLDPRT, Clamp.SLDPRT, Drag Chain Link.SLDPRT, Drag Chain Link.STL]
2020-02-17 Added PCB models
    [LED Controller.SLDPRT, LED Controller.step, LED Module.SLDPRT, LED Module.step, Pi Hat.SLDPRT, Pi Hat.step, Power Entry.SLDPRT, Power Entry.step]
2020-02-17 Added chess board models
    [Board.SLDASM, Clear Board Epoxy.SLDPRT, Tile.SLDPRT, Trim.SLDPRT]
2020-02-17 Added pieces
    [Bishop.SLDPRT, Bishop.STL, Board.SLDASM, king.STL, knight.SLDPRT, knight.STL, pawn.SLDPRT, pawn.stl]
2020-02-17 Added standoffs and touch screen
    [Standoff.SLDPRT, Touch Screen.SLDPRT]
2020-02-17 Made box
    [Axle.SLDPRT, Bearing.SLDPRT, Belt.SLDPRT, Bottom.SLDPRT, Box.SLDASM, Clamp Plate.SLDPRT, Clamp.SLDPRT, Gantry.SLDASM]
2020-02-17 Added power supply
    [Box.SLDASM, Magnetic Chess.SLDASM, Side.SLDPRT]
2020-02-17 Added other commercial parts
    [Electromagnet.SLDPRT, Fan.SLDPRT, Power Plug.SLDPRT]
2020-02-19 Modeled lots of it in SolidWorks
    [Axle.SLDPRT, Base Pulley Rod.SLDASM, Bearing Flange.SLDPRT, Bearing.SLDPRT, Belt.SLDPRT, Bottom.SLDPRT, Box.SLDASM, Cross-Axis Support.SLDPRT]
2020-02-19 More updates to box design
    [Base Pulley Rod.SLDASM, Bottom.SLDPRT, Box.SLDASM, Lid.SLDASM, Magnetic Chess.SLDASM, Screen Side.SLDPRT, Secondary Axis.SLDASM, Side.SLDPRT]
2020-02-19 Finished up SolidWorks model
    [Axle.SLDPRT, Base Pulley Rod.SLDASM, Bottom.SLDPRT, Box.SLDASM, Magnetic Chess.SLDASM, PSU Side.SLDPRT, PSU Top.SLDPRT, Secondary Axis.SLDASM]
2020-02-19 Wrote skeletons for hardware drivers
2020-02-20 Made all the wood MDF
    [Base Pulley Rod.SLDASM, Bearing Flange.SLDPRT, Bottom.SLDPRT, Box.SLDASM, Lid.SLDASM, Magnet Holder.SLDASM, Magnet Holder.SLDPRT, Magnetic Chess.SLDASM]
2020-02-20 Added dovetails
    [Bottom.SLDPRT, Box.SLDASM, Lid.SLDASM, Magnetic Chess.SLDASM, Side.SLDPRT, Top.SLDPRT]
2020-02-20 Added laser-cutting file
    [0.25in MDF - Magnetic Chess.SLDASM, Bottom.SLDPRT, Box.SLDASM, Laser Sheet.SLDPRT, Lid.SLDASM, Magnetic Chess.SLDASM, Side.SLDPRT, Top.SLDPRT]
2020-02-21 Cleaned up stepper driver
2020-02-21 Created laser-cutting files
    [0.25in MDF - Magnetic Chess - 1.dxf, 0.25in MDF - Magnetic Chess - 2.dxf, 0.25in MDF - Magnetic Chess - 3.dxf, 0.25in MDF - Magnetic Chess - 4.dxf, 0.25in MDF - Magnetic Chess - 5.dxf, 0.25in MDF - Magnetic Chess - 6.dxf, 0.25in MDF - Magnetic Chess - 7.dxf, 0.25in MDF - Magnetic Chess - 8.dxf]
2020-02-23 Created 3D printing files
    [Cross-Axis Support - Driver.STL, Cross-Axis Support - Idler.STL, Cross-Axis Support.SLDPRT, Fan Mount.STL, Magnet Holder.STL, Magnetic Chess.SLDASM, Secondary Axis.SLDASM, Trim.STL]
2020-02-26 Fixed some problems with the printed parts
    [Cross-Axis Support - Driver.STL, Cross-Axis Support - Idler.STL, Cross-Axis Support.SLDPRT, Magnet Holder.SLDASM, Magnet Holder.SLDPRT, Magnet Holder.STL, Magnetic Chess.SLDASM, Secondary Axis.SLDASM]
2020-02-28 Designed pulley spacer
    [Pulley Spacer.SLDPRT, Pulley Spacer.STL]
2020-03-01 Proxied rpc methods into magnetic-chess.js methods
2020-03-06 Created jig for soldering LED modules together
    [LED Module Jig.SLDASM, LED Module Jig.SLDPRT, LED Module Jig.STL]
2020-03-09 Created logo for app
    [king.DXF]
2020-03-10 Worked on logic.c
    Finished board reset and added getmoves for rook
    [logic.c]
2020-03-11 started magnet.ino
2020-10-07 Basic UI framework and chess piece movement added
    --Added chess piece movement, coordinate interpretation
    --Added basic UI framework and styling
    --Added image assets (these are from wikimedia, attribution will come later)
2020-10-07 Revert "Merge branch 'master' of https://github.com/ksu-eclub/magnetic-chess"
    This reverts commit ea173fd52c3bd7b0f124d74abdd83c6e1d2f66b7, reversing
    changes made to 6094d07b73f3d3bad6c6a041d6815f238d70e16d.
2021-01-14 nicholasgerhold@ksu.edu
    added a board converter function to change an 8 by 8 array into a 64 char array, also added onchange and onselect to the reset board and get moves functions respectively.
    [logic.c]
